TakaI2/Drone_simulate/.tmp/requirements.md

# 要件定義書（plan.txt 精査・ブラッシュアップ版）

作成日: 2026-09-26
元資料: `plan.txt`

---

## 0. plan.txt の精査結果（専門的観点からの指摘）

### 0.1 構成上の指摘

| # | 指摘 | 対応方針 |
|---|---|---|
| A1 | 本文の機能は 1〜4 だが、ゴールは「1〜5 の各段階」「5 の完成機体」となっており段階数が矛盾している。 | 段階5を「統合（Sim-to-Real ループ）」として新設する。設計した実機パラメータでシミュレーションを再実行し、完成機体の3Dを UI に表示する段階とする。 |
| A2 | 段階1（シミュレーション）は機体の質量・慣性・推力係数を必要とするが、それらは段階2・4で決まる。順序どおり進めると段階1のドローンは「仮の機体」になる。 | 全段階で共有する単一の設計データモデル（`DroneDesign`）を定義する。段階1は参照プリセットで実施し、段階5で実設計値を流し込んで再検証する。 |
| A3 | 「偏向しない固定プロペラ」で「単一または複数の推進力」とあるが、固定ピッチ・非偏向ロータでは姿勢4自由度（推力＋ロール・ピッチ・ヨー）の制御に最低4ロータが必要。単発・双発・三発は操舵翼やチルト機構が必須となる。 | 任意 N 基のロータ配置を受け付け、制御配分行列のランク検査で「制御可能か」を判定・警告する。既定はクアッド X 型とし、ヘキサ・オクタも可とする。 |

### 0.2 電気系統の指摘

| # | 指摘 | 対応方針 |
|---|---|---|
| B1 | Raspberry Pi（Linux）はリアルタイム OS ではない。数百 Hz〜kHz の姿勢制御ループを担うフライトコントローラ（FC）には不適。業界の定石は「マイコン FC ＋ Linux コンパニオンコンピュータ」の二層構成。 | 内側ループ（姿勢・角速度制御）はマイコン（ESP32-S3 / STM32 など）が担う。Raspberry Pi は経路計画・画像処理などのコンパニオン（任意）とする。 |
| B2 | ブラシレスモータ用 ESC をディスクリート部品で自作するのは、三相インバータ・ゲートドライバ・センサレス転流が必要で難度が高く、発火リスクもある。 | 機体を2クラスに分ける。**クラスA**（既定）は100g未満のマイクロ機で、ブラシ付きコアレスモータを MOSFET で駆動する。全回路をディスクリート部品と汎用モジュールで構成でき、学習と安全性に優れる。**クラスB** は250mm級のブラシレス機で、ESC は市販品（オープンソースファームウェア AM32 対応品）を採用する。 |
| B3 | 「自律飛行（目標地点・経路）」には自己位置推定が必須。屋内では GPS が使えない。 | クラスAはオプティカルフロー（PMW3901）とToF距離センサ（VL53L1X）で位置推定する（Crazyflie Flow deck と同じ定石）。クラスBは GNSS を使う。シミュレータにもこれらのセンサモデルを入れる。 |
| B4 | MPU-6050 など定番 IMU は製造終了（EOL）品が多く、「替えがきく」方針に反する。 | 現行品（ICM-42688-P、BMI270、LSM6DSO）を採用し、代替候補を必ず併記する。 |
| B5 | 1S LiPo はモータ負荷時に電圧が大きく下がる（サグ）。3.3V レギュレータのドロップアウトでマイコンがブラウンアウトする事故が典型。 | 低ドロップアウト LDO＋バルクコンデンサを使い、電源系を分離する。電圧降下を回路計算とシミュレーション（電池内部抵抗モデル）の両方で扱う。 |

### 0.3 部品・基板の指摘

| # | 指摘 | 対応方針 |
|---|---|---|
| C1 | 販売サイトの自動スクレイピングは多くのサイトで利用規約違反になる。価格・在庫は日々変わる。 | 部品カタログは型番・仕様・寸法・重量を持つローカル DB とする。販売先は各サイトの検索 URL を生成する形にする。将来、公式 API（Digi-Key、Mouser、Nexar/Octopart）連携を追加できる設計にする。 |
| C2 | 「ディスクリート部品の全種類の3Dモデル」は品種が事実上無限で実現不能。 | 規格化された**パッケージ**（EIA チップ 0402〜1206、アキシャル、ラジアル、TO-92、SOT-23、SOIC、QFN、TO-220、ピンヘッダ、JST コネクタ等）ごとのパラメトリック生成器を作る。寸法を入れれば任意の部品を生成できる。高精度モデルが要る場合は KiCad 公式3Dライブラリ（CC-BY-SA 4.0＋設計物例外）を任意で参照する。 |
| C3 | 基板の自動配線は業界ツールでも完全ではない。発注前には必ず人の確認と DRC が必要。 | 自前の2層グリッド配線器で「自動配置→自動配線→GND ベタ→スティッチングビア→サーマルビア→DRC→Gerber 出力」を行う。KiCad で開ける形式でも出力し、人が最終確認・修正できる導線を残す。 |
| C4 | 基板製造サービス（JLCPCB、PCBWay 等）には最小線幅・クリアランス・穴径の制約がある。 | 設計ルールを設定値として外出しする。既定は余裕を持った値（線幅0.2mm、クリアランス0.2mm、ビア0.6/0.3mm）とする。 |

### 0.4 機体設計・法規・その他の指摘

| # | 指摘 | 対応方針 |
|---|---|---|
| D1 | 日本の航空法では 100g 以上の機体は「無人航空機」となり、機体登録とリモート ID が必要。飛行場所の制限も大きい。 | 初号機は 100g 未満（模型航空機扱い）を目標にする。重量予算を常時表示し、100g 超過時に警告する。 |
| D2 | 無線モジュールは日本国内で使うには技適が必要。 | 技適取得済みモジュール（ESP32-S3-WROOM-1、M5Stamp S3 等）のみをカタログで推奨扱いにする。 |
| D3 | シミュレーションと実機の差（Sim-to-Real ギャップ）の主因は推力係数・モータ時定数・慣性モーメントの誤差。 | 推力台での実測値（推力係数 kT、トルク係数 kQ、時定数）を設計データに上書きできるようにし、測定手順をレポートに記載する。 |
| D4 | プロペラ同士、プロペラとフレームの干渉、および CG と推力中心のずれは実機で墜落の主因。 | 機体設計で干渉チェック（プロペラ間隙間）と、CG と推力中心のずれの評価を自動で行う。 |
| D5 | LiPo 電池は過放電・短絡で発火する。 | 電池電圧監視回路（分圧＋ADC）を必須回路とし、低電圧時の自動着陸をシミュレータとファームウェア要件に含める。 |

### 0.5 ライセンス方針（商用利用の観点）

GitHub API で 2026-09-26 に確認した結果は以下のとおり。

| プロジェクト | ライセンス | 本プロジェクトでの扱い |
|---|---|---|
| three.js | MIT | 取り込む（3D 描画） |
| three-bvh-csg / three-mesh-bvh | MIT | 取り込む（ブーリアン演算） |
| PX4-Autopilot | BSD-3-Clause | 制御構造（カスケード PID、ミキサ）の**設計**を参考にする |
| jMAVSim | BSD-3-Clause | 物理モデルの設計を参考にする |
| gym-pybullet-drones / RotorPy / crazyflie-simulation | MIT | 動力学・パラメータ値を参考にする |
| ArduPilot / Betaflight / ESP-Drone / Crazyflie FW / AM32 | GPL-3.0 | **コードは取り込まない**。アルゴリズムと構成の参考のみ。実機ファームウェアをこれらから派生させる場合、そのファームウェアは GPL-3.0 で公開義務が生じる |
| Freerouting | GPL-3.0 | 取り込まない。外部ツールとして任意で使う手順のみ案内する |
| SKiDL | MIT | 参考（本ツールは TypeScript でネットリストを生成） |
| KiCad 3D ライブラリ | CC-BY-SA 4.0（設計物例外あり） | 同梱しない。任意参照とする |
| AirSim / Flightmare | API 判定不能（NOASSERTION） | 参考のみ。コード流用しない |

**結論**: 本ツール本体は MIT/BSD/Apache 系の依存のみで構成し、GPL コードは取り込まない。これにより本ツールの商用利用に制約は生じない。

---

## 1. 目的

飛行体（固定ピッチ・非偏向の多ロータ機）の、シミュレーション・電気設計・基板設計・機体設計を一貫して支援するツールを作る。設計データを単一モデルで共有し、シミュレーション結果と実機設計が整合することを目指す。

## 2. 段階別の機能要件とゴール（合格基準）

各段階はゴール判定をスクリプトで自動化する。結果とスクリーンショットを HTML レポート（`reports/stageN.html`）に出力する。

### 段階1: 飛行空間・シミュレーション

**機能**
- F1-1 Three.js による 3D 空間。重力・空気密度・風（平均風ベクトル＋突風）を設定できる。
- F1-2 地面と障害物（直方体・円柱）、開始点、目標点、経由点をコース定義（JSON）で設定できる。
- F1-3 6自由度剛体動力学。モータ一次遅れ、推力 ∝ ω²、反トルク、空気抵抗、地面効果、電池電圧降下を含む。
- F1-4 センサモデル（IMU ノイズ・バイアス、気圧計、位置センサ）と状態推定。
- F1-5 カスケード制御（位置→速度→姿勢→角速度）と制御配分（任意 N ロータ）。
- F1-6 自律飛行: 障害物を避ける経路計画（3D A*）と経路追従。
- F1-7 手動飛行: キーボード操作。
- F1-8 飛行軌跡の表示、テレメトリ表示、衝突検出。

**ゴール**
| ID | シナリオ | 合格基準 |
|---|---|---|
| G1-1 | 高度1mホバリング10秒（センサノイズあり） | 定常高度誤差 RMS < 0.05 m |
| G1-2 | 正方形コース経由点飛行 | 全経由点を 0.15 m 以内で通過 |
| G1-3 | 障害物コース自律飛行 | 衝突なし、目標到達誤差 < 0.2 m |
| G1-4 | 平均風 3 m/s＋突風 1 m/s 中のホバリング | 水平位置誤差の最大値 < 0.5 m |
| G1-5 | 電池電圧降下 | 低電圧時に自動着陸し、墜落しない |

### 段階2: 推進系サイジングと電気系統設計

**機能**
- F2-1 目標全備重量・推力重量比から、プロペラ・モータ・電池の必要スペックを算出する（運動量理論）。
- F2-2 飛行時間・ホバリング電流・最大電流を推定する。
- F2-3 回路（電源、マイコン、センサ、モータ駆動、電池監視）を自動生成し、各部品の理想スペックを計算する（MOSFET 電流余裕、ゲート抵抗、LDO 電流・ドロップアウト、分圧比など）。
- F2-4 回路図（SVG）、ネットリスト、BOM を出力する。全部品に代替品を1つ以上併記する。

**ゴール**
| ID | 合格基準 |
|---|---|
| G2-1 | 推力重量比 ≥ 2.0、ホバリングスロットル ≤ 60 % |
| G2-2 | 推定ホバリング飛行時間 ≥ 5 分 |
| G2-3 | 電気的検証（電流余裕2倍以上、ADC 入力範囲内、LDO 余裕）がすべて合格 |
| G2-4 | ネットリストに未接続ピン（意図的な NC を除く）がない |

### 段階3: 部品選定・3Dモデル・ブレッドボード・基板設計

**機能**
- F3-1 BOM の各部品を部品カタログ（型番・寸法・重量・仕様・購入先検索 URL）に対応付ける。
- F3-2 パッケージ規格ごとのパラメトリック3Dモデル生成と、アーカイブ（GLB/STL）出力を行う。
- F3-3 ブレッドボード配置図（SVG）を作る。
- F3-4 PCB の自動配置、2層自動配線、GND ベタ、スティッチングビア、発熱部品下のサーマルビア、DRC を行う。
- F3-5 Gerber（RS-274X）とドリル（Excellon）を出力し、基板製造サービスに入稿できる ZIP にまとめる。
- F3-6 実装済み基板の3D表示を行う。

**ゴール**
| ID | 合格基準 |
|---|---|
| G3-1 | BOM 全部品がカタログに対応し、寸法・重量を持つ |
| G3-2 | 使用する全パッケージの3Dモデルが生成される |
| G3-3 | PCB の全ネットが配線済み（未配線 0） |
| G3-4 | DRC（クリアランス・線幅・穴径）違反 0 |
| G3-5 | Gerber 一式とドリルファイルが出力される |

### 段階4: 機体総合設計

**機能**
- F4-1 プロペラ径とクリアランスから腕長を決めるパラメトリックフレームを生成する。
- F4-2 部品配置（基板、電池、モータ、センサ）を行い、質量特性（重心、慣性テンソル）を計算する。
- F4-3 重心と推力中心が一致するよう電池位置を自動調整する。
- F4-4 3Dプリント用 STL を出力する。
- F4-5 電子部品を搭載した機体の3Dを UI で確認できる。

**ゴール**
| ID | 合格基準 |
|---|---|
| G4-1 | 重心と推力中心の水平ずれ < 2 mm |
| G4-2 | プロペラ間・プロペラとフレームの隙間 ≥ 5 mm |
| G4-3 | 出力 STL が閉じた多様体（watertight） |
| G4-4 | 全備重量 < 100 g（クラスA） |

### 段階5: 統合（Sim-to-Real ループ）

**機能**
- F5-1 段階2〜4の設計値（質量、慣性、腕長、推力係数、電池）からシミュレーション用パラメータを自動導出する。
- F5-2 段階1のシナリオを実設計値で再実行し、参照機との比較を行う。
- F5-3 完成機体（フレーム＋基板＋部品＋モータ＋プロペラ＋電池）の3Dを UI 上で表示し、そのまま飛行シミュレーションできる。

**ゴール**
| ID | 合格基準 |
|---|---|
| G5-1 | 実設計値で G1-1〜G1-5 に合格 |
| G5-2 | 完成機体の3Dが UI に表示される（スクリーンショットで確認） |

## 3. 非機能要件

- TypeScript（`any`/`unknown` 禁止、`class` 原則禁止）で実装する。
- コア計算（物理・制御・設計）はブラウザ非依存とし、Node でもテストとバッチ実行ができる。
- 物理は固定刻み 1 kHz、制御は 500 Hz、描画は 60 fps で分離する。
- 設定値はハードコードせず、プリセット・設定ファイルに外出しする。
- 各段階の検証は `npm run stageN` で再現できる。

## 4. スコープ外（今回実施しない）

- 実機ファームウェアの実装（要件と構成案のみ示す）
- 販売サイトのリアルタイム価格取得（API キーが必要なため拡張ポイントのみ用意）
- 構造解析（FEM）と振動解析

---

## 改良版 B（2026-09-27 追加）

元の設計（以下「版 A」：既製フロー＋ToF モジュールをケーブル接続）は変更せずに残し、改良版 B を並行して作る。

### 背景（版 A の課題）
- フロー＋ToF は既製ブレイクアウト頼みで、回路・基板・3D を設計していない（plan.txt の「ディスクリート中心」方針から外れる）。
- メイン基板の J2 とプレート下のモジュールをつなぐケーブルの通り道がフレームにない。
- GNSS（屋外飛行）の接続手段がない。

### 機能要件
- FB-1 フロー（PMW3901 系）＋ToF（VL53L1X）を載せた**センサ子基板**を回路・基板・Gerber・3D まで自動生成する。1.8 V 系電源（フローセンサのコア電圧）を子基板上で作る。
- FB-2 子基板はメイン基板と同じ 8 ピン配列の JST-SH で接続し、フレーム機首の M2 穴 2 個で固定する。部品面を床に向けて取り付ける。
- FB-3 フレームにケーブル通し穴を追加する。
- FB-4 版 B のメイン基板に GNSS 用 JST-SH 6 ピン（3V3・GND・UART TX/RX・I²C）を追加する（モジュール本体は未搭載）。
- FB-5 GNSS の誤差モデル（ゆっくり変動する位置誤差）を追加し、GNSS モジュール装着時の屋外飛行をシミュレーションで検証する。
- FB-6 版 A と版 B の重量・重心・飛行性能を比較する HTML レポートを出力する。UI でも版 B の完成機体を表示・飛行できる。

### ゴール
| ID | 合格基準 |
|---|---|
| GB-1 | 子基板: 全ネット配線・DRC 違反 0・Gerber 構文エラー 0 |
| GB-2 | 版 B メイン基板: 全ネット配線・DRC 違反 0（GNSS コネクタ込み） |
| GB-3 | 版 B 機体: 重心ずれ < 2 mm、STL が閉じた多様体、全備重量 < 100 g |
| GB-4 | 版 B で G1-1〜G1-5 に合格 |
| GB-5 | GNSS 装着の屋外シナリオ（経由点飛行・耐風ホバリング）に合格 |

## 改良版 C：屋外飛行機（2026-09-27 追加）

版 A・版 B は変更せずに残し、屋外（GNSS）で風の中を飛べる機体を「版 C」として同じ段階の進め方（要件→設計→判定スクリプト→HTML レポート）で設計する。

### 背景（屋外で問題になる点と既存資産の流用可否）
| 資産 | 屋外での課題 | 版 C での扱い |
|---|---|---|
| メイン基板（ESP32-S3・IMU・気圧・GNSS 端子） | マイコン・センサ・GNSS 端子はそのまま使える。電源が 1S 専用 LDO（入力 6 V 上限）、モータ駆動がブラシ付き用 MOSFET | **回路ブロックを流用**し、電源を降圧 DC-DC（2〜4S 入力）、モータ駆動を市販 4-in-1 ESC 用端子に差し替えた派生基板を自動生成 |
| センサ子基板（フロー＋ToF） | ToF は日光下で測距距離が大きく低下し、フローは高度数 m 以上で精度が落ちる | 必須にしない。J2 端子は残し、低高度の精密着陸用オプションとして**そのまま装着可能** |
| GNSS＋コンパス（M10 系） | 屋外航法の必須センサ | **そのまま流用**（版 B の 6 ピン端子と同じ配列） |
| 8520 ブラシ付きモータ | 推力重量比 2 前後で強風時の余裕が小さく、ブラシ摩耗・発熱で連続高負荷に弱い | 耐風性能をシミュレーションで比較したうえで、**ブラシレスに変更** |
| フレーム生成器 | モータ固定がブラシ付き用チューブ | 生成器を拡張（ブラシレス用ボルト固定台座・ESC 台・GNSS 台）して**流用** |
| 制御・推定・計画 | 屋外 GNSS 飛行は版 B で検証済み | **流用**。通信断・低電圧時の自動帰還（RTH）を追加 |

### 法規・運用の前提（日本）
- 100 g 未満を維持する（航空法の無人航空機に当たらず、機体登録・リモート ID が不要）。設計目標は組立ばらつきを見込んで 95 g 未満。
- 100 g 未満でも小型無人機等飛行禁止法（重要施設周辺）、空港周辺・高度 150 m 以上の制限、自治体条例・公園ルールは適用される。
- 2.4 GHz 無線は技適取得済みモジュール（ESP32-S3-WROOM-1）のみ。GNSS は受信のみ。
- 100 g 以上の構成（例：250 級 5 インチ）は比較対象としてだけ示す。

### 機能要件
- FC-1 屋外用の部品候補（ブラシレス 11〜14 級モータ、2.5〜3.5 インチプロペラ、2S/3S 電池）と屋外用設計基準（推力重量比 ≥ 3、ホバリングスロットル ≤ 45 %、飛行時間 ≥ 7 分、全備重量 < 95 g）で推進系を探索する。版 A の候補表・探索結果は変えない。
- FC-2 版 B のメイン基板回路から、電源（降圧 DC-DC）とモータ出力（ESC 用 JST-SH 8 ピン：電源・電流・4 信号・テレメトリ）を差し替えた版 C 基板を生成し、電気計算（降圧器・分圧器・ESC 電流余裕等）を行う。
- FC-3 版 C 基板を自動配置・配線し、DRC・Gerber・KiCad・3D を出力する。
- FC-4 フレーム生成器にブラシレスモータ用ボルト固定台座、ESC スタック、GNSS 台座（機首上面）を追加し、重心・隙間・強度・STL を検証する。
- FC-5 通信断・低電圧時に自動帰還（上昇→ホームへ移動→着陸）するフェイルセーフを追加する。
- FC-6 屋外シナリオ（耐風ホバリング、広域の経由点飛行、強風、自動帰還）と、版 B（GNSS 装着）との耐風限界比較をシミュレーションで行う。
- FC-7 版 C の HTML レポート（流用判断、探索、回路、基板、機体、飛行、懸念点）と UI 表示（完成機体・基板・屋外飛行）。

### ゴール
| ID | 合格基準 |
|---|---|
| GC-1 | 屋外基準を満たす推進系が存在し、全備重量 < 95 g、TWR ≥ 3 |
| GC-2 | 版 C 回路の電気計算が全項目合格、1 ピンだけのネットなし |
| GC-3 | 版 C 基板：全ネット配線・DRC 違反 0・Gerber 構文エラー 0 |
| GC-4 | 版 C 機体：重心ずれ < 2 mm、STL 閉多様体、プロペラ隙間、腕強度安全率 ≥ 3、全備重量 < 100 g |
| GC-5 | 屋外シナリオ（平均風 5 m/s ホバリング・40 m 経由点飛行・平均風 8 m/s 強風）各 5 シードで合格 |
| GC-6 | 通信断で自動帰還し、ホームから 3 m 以内に着陸（5 シード） |
| GC-7 | 平均風 8 m/s のホバリングでモータ指令（99 パーセンタイル）が 60 % 以下、かつ版 B（GNSS 装着、同じ屋外制御設定）より推力余裕が大きい |

- GC-7 は当初「耐風限界（位置保持できる最大風速）が版 B を上回る」としていたが、試算で耐風限界は抗力/質量比と傾き制限でほぼ決まり、版 B と版 C で差が出ないことが分かったため（抗力モデル ×1・×2 とも同等）、設計で差が出る「推力余裕」に改めた。耐風限界の比較はレポートに参考として載せる。

## 都市シミュレーション：横浜・みなとみらい（2026-09-28 追加）

実在の街並み（建物）を読み込み、屋外機（版 C）の飛行・経路計画をシミュレーションで検証できるようにする。

### データとライセンス
| データ | 用途 | ライセンス・表記 |
|---|---|---|
| OpenStreetMap（Overpass API） | 建物外形・高さ／階数タグ、公園 | ODbL。「© OpenStreetMap contributors」を表示。加工 DB を配布する場合は同条件 |
| PLATEAU 横浜市（2024 年度、CityGML v4、建築物 LOD1） | 建物外形と高さ（主データ） | PLATEAU サイトポリシー（CC BY 4.0 相当）。「3D 都市モデル（Project PLATEAU）横浜市（2024 年度）（国土交通省）を加工して作成」 |

- PLATEAU の CityGML は市全体で 2.7 GB の ZIP。ZIP の中央ディレクトリを HTTP Range で読み、対象の 3 次メッシュ（53391540・53391550）の建築物ファイルだけを取得する。
- 取得した生データは `.cache/`（Git 管理外）、変換後の建物データは `out/city/` に置く。

### 機能要件
- FY-1 緯度経度を対象地域の原点を基準とする ENU（m）に変換し、建物を「外形ポリゴン × 高さ」の角柱障害物にする。
- FY-2 角柱障害物を当たり判定・経路計画（ボクセル A*）に対応させる。数百 m 規模でも実用的な時間で計画できること（空間インデックス、列単位のボクセル化）。
- FY-3 GNSS の都市劣化：地点ごとの天空の見通し率（建物に遮られない空の割合）から位置誤差を拡大し、見通しが極端に悪い所では測位が途切れる。
- FY-4 高さで変わる風（べき乗則）。
- FY-5 法規チェック：飛行高度（地表から 150 m 未満）、公園（横浜市の公園は原則ドローン禁止のため要確認）との交差、人口集中地区の注意喚起。
- FY-6 UI で都市モデルと飛行を 3D 表示する。HTML レポートを出力する。

### ゴール
| ID | 合格基準 |
|---|---|
| GY-1 | OSM と PLATEAU から対象範囲の建物を取得・変換できる。高さの一致をランドマークタワー等で確認 |
| GY-2 | 高度 40 m で建物群を縫う経路を計画でき、建物からの距離が安全余裕以上 |
| GY-3 | 開けた空を仮定した GNSS で、版 C が経路を 5 シードすべて衝突なく飛行・着陸 |
| GY-4 | 天空見通しによる GNSS 劣化＋高さの風を入れても 5 シードすべて衝突なし（必要なら安全余裕を設計し直す） |
| GY-5 | 経路の法規チェック結果（高度・公園・DID）をレポートに出す |
| GY-6 | UI で都市と飛行の 3D 表示ができる（スクリーンショット） |

## 予算（部品価格）（2026-09-28 追加）

- FP-1 部品ごとの参考価格表を作る。価格は Web 検索で個別に確認した値（販売サイトの自動収集はしない）と、確認できなかった品目の推定値を区別し、参照元・確認日・価格幅（下限〜上限）を付ける。
- FP-2 版 A・B・C について「1 機分の部品代」と「初回に必要な費用（基板の最小ロット、実装費、送料、税、予備）」を計算する。道具（充電器、書込み治具など）は別枠。
- FP-3 為替・送料・税率・購入数は設定（`src/budget/prices.ts`）で変えられる。
- FP-4 HTML レポート（`reports/budget.html`）と CSV を出力する。

| ID | 合格基準 |
|---|---|
| GP-1 | 版 A・B・C の BOM の全品目に価格が付いている（価格なし 0） |
| GP-2 | 各版の 1 機分・初回費用・道具の合計と内訳、価格幅を出力 |
