TakaI2/Drone_simulate/.tmp/tasks.md

# タスクリスト

| # | タスク | 段階 | 状態 |
|---|---|---|---|
| 0 | プロジェクト雛形（Vite、TS、Vitest、ESLint、git） | 0 | 完了 |
| 1 | core: 数学ライブラリ、型、乱数、プリセット | 1 | 完了 |
| 2 | sim: モータ、電池、風、動力学、衝突、センサ、推定器 | 1 | 完了 |
| 3 | control: PID、カスケード制御、配分、飛行モード | 1 | 完了 |
| 4 | planning: ボクセル、A*、短縮、追従 | 1 | 完了 |
| 5 | sim: シミュレータ本体、シナリオ G1-1〜G1-5 | 1 | 完了 |
| 6 | ui: シミュレーション画面（環境、軌跡、テレメトリ、手動操作） | 1 | 完了 |
| 7 | scripts: 段階1判定、撮影、HTML レポート | 1 | 完了 |
| 8 | sizing: 推進系サイジングと組合せ探索 | 2 | 完了 |
| 9 | electrical: カタログ、回路生成、計算、回路図 SVG、BOM | 2 | 完了 |
| 10 | ui＋レポート: 段階2 | 2 | 完了 |
| 11 | parts3d: パッケージ生成器、アーカイブ | 3 | 完了 |
| 12 | pcb: フットプリント、配置、配線、GND、ビア、DRC | 3 | 完了 |
| 13 | pcb: Gerber・ドリル・ZIP、ブレッドボード図 | 3 | 完了 |
| 14 | ui＋レポート: 段階3 | 3 | 完了 |
| 15 | airframe: フレーム生成、質量特性、バランス、STL | 4 | 完了 |
| 16 | ui＋レポート: 段階4 | 4 | 完了 |
| 17 | integration: パラメータ導出、再シミュレーション、比較 | 5 | 完了 |
| 18 | ui＋レポート: 段階5、総合目次 | 5 | 完了 |
| 19 | GitHub へ push | - | 完了 |

## 実装結果（2026-09-26）

- 全タスク完了。`npm run all` で段階1〜5 のゴール判定（全 21 項目合格）・成果物・HTML レポートを再生成できる。
- 単体テスト 25 件（`npm test`）、型検査・lint（`npm run typecheck` / `npm run lint`）すべて合格。

## 改良版 B

| # | タスク | 状態 |
|---|---|---|
| B1 | 回路: GNSS コネクタ（オプション）、子基板回路、部品カタログ | 完了 |
| B2 | 基板パイプライン: 長方形基板・取付穴位置指定、子基板の配置配線 | 完了 |
| B3 | フレーム: ケーブル穴、子基板の質量・3D | 完了 |
| B4 | センサ: GNSS 誤差モデル、屋外シナリオ | 完了 |
| B5 | スクリプト・比較レポート・UI の版切替 | 完了 |
| B6 | テスト・lint・コミット | 完了 |

- 改良版 B 完了（2026-09-27）：`npm run variantB` で GB-1〜GB-5 全合格。推定器の傾き観測性の欠陥を修正（版 A も再検証済み・全合格）。

## 改良版 C（屋外機）

| # | タスク | 状態 |
|---|---|---|
| C1 | 屋外用推進系候補・基準・質量モデル、探索の差し替え | 完了 |
| C2 | 回路: 降圧 DC-DC・ESC 端子オプション、部品カタログ、電気計算 | 完了 |
| C3 | 基板: 版 C 基板の配置配線・Gerber | 完了 |
| C4 | フレーム: ボルト固定台座・ESC スタック・GNSS 台座、3D | 完了 |
| C5 | シミュレーション: RTH、屋外ゲイン、屋外シナリオ、耐風限界 | 完了 |
| C6 | スクリプト・レポート・UI（版 C） | 完了 |
| C7 | テスト・lint・コミット | 完了 |

- 改良版 C 完了（2026-09-27）：`npm run variantC` で GC-1〜GC-7 全合格。構成は 1204 5000KV・3 インチ 3 枚羽・2S 450 mAh・市販 4-in-1 ESC、全備 93.6 g、基板 38×38 mm。
- 試算で分かったこと：位置を保てる最大風速は抗力/質量比と傾き制限でほぼ決まり、版 B＋GNSS と版 C で差がない。版 C の利点は推力余裕（平均風 8 m/s でモータ指令 34 % 対 53 %）と耐久性。GC-7 をこれに合わせて改めた。

## 都市シミュレーション（横浜）

| # | タスク | 状態 |
|---|---|---|
| Y1 | geo：ENU・OSM・CityGML 解析、データ取得とキャッシュ | 完了 |
| Y2 | 角柱障害物：当たり判定・索引・ボクセル化・計画パラメータ | 完了 |
| Y3 | 天空見通しと GNSS 劣化、高さの風 | 完了 |
| Y4 | シナリオ・法規チェック・スクリプト・レポート | 完了 |
| Y5 | UI（都市タブ） | 完了 |
| Y6 | テスト・lint・コミット | 完了 |

- 都市シミュレーション完了（2026-09-28）：`npm run city` で GY-1〜GY-6 全合格。安全余裕 3 m では都市の GNSS 劣化で 1/5 シードが建物に接触、8 m で全シード接触なし。
- 途中で推定器の不具合（長距離飛行後に傾き推定が約 9° ずれ、推定速度に偽の 1.4 m/s）を発見。GNSS 補助の傾き補正からジャイロバイアスも推定するよう修正し、段階1〜5・版 B・版 C を再検証（全合格）。
- ユーザーマニュアル `docs/manual.md` を新規作成（`npm run manual` でスクリーンショット更新）。

## 予算（後続）

| # | タスク | 状態 |
|---|---|---|
| P1 | 部品価格表（参照元・調査日付き）と版 A/B/C の予算計算・レポート | 完了 |
| P2 | 価格表（Web 確認分／推定分）・予算計算・レポート・マニュアル追記 | 完了 |

- 予算完了（2026-09-28）：`npm run budget`。1 機分 A 約 1.2 万円・B 約 1.4 万円・C 約 2.4 万円、初回 A 約 3.7 万・B 約 4.4 万・C 約 5.2 万円。価格調査で、小型 12 A の AM32 単体 ESC がほぼ市販されていないこと、市販 M10 GNSS が 7.7 g（想定 5 g より重い）ことが判明。
