TakaI2/Drone_simulate/docs/img/ui-6-city-follow.png

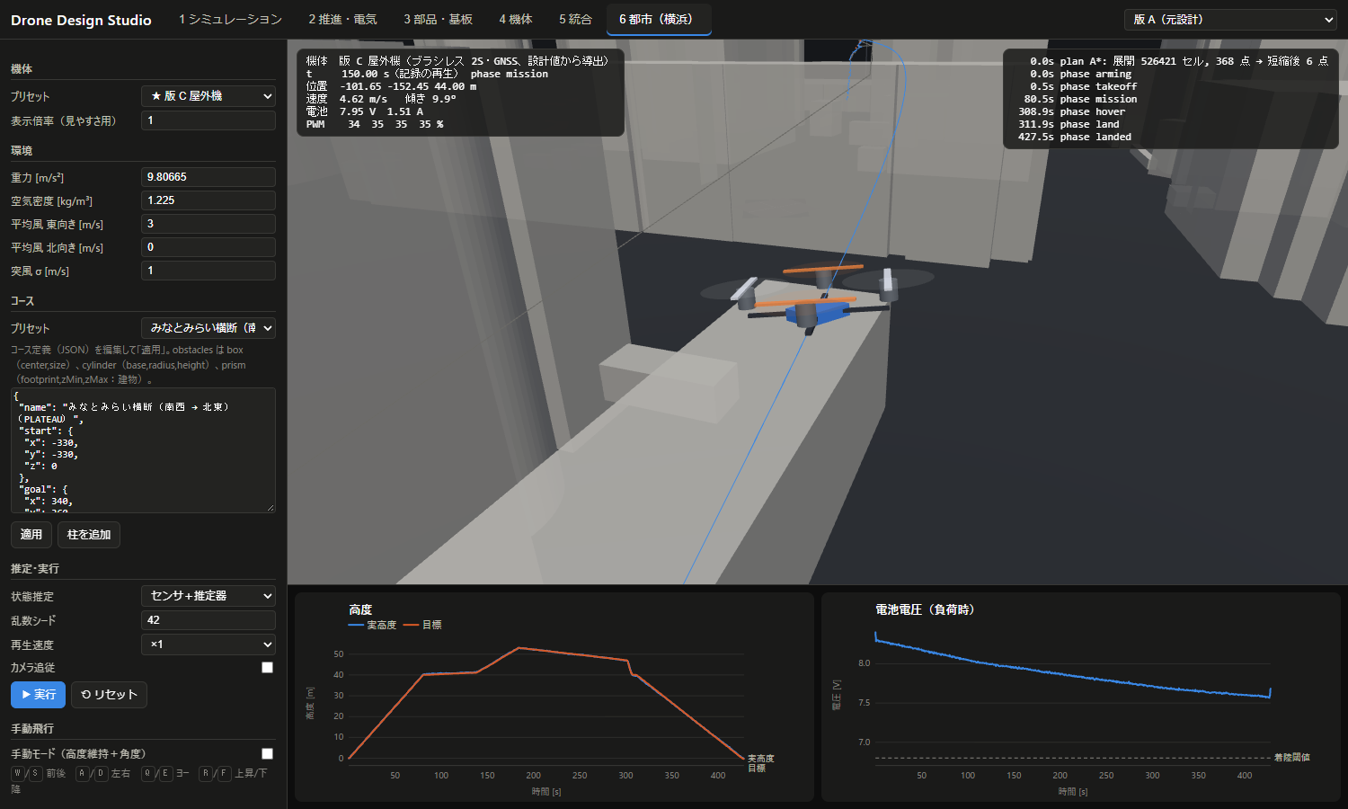
docs/img/ui-6-city-follow.png
