TakaI2/Drone_simulate/docs/video/airframe-a-orbit.png

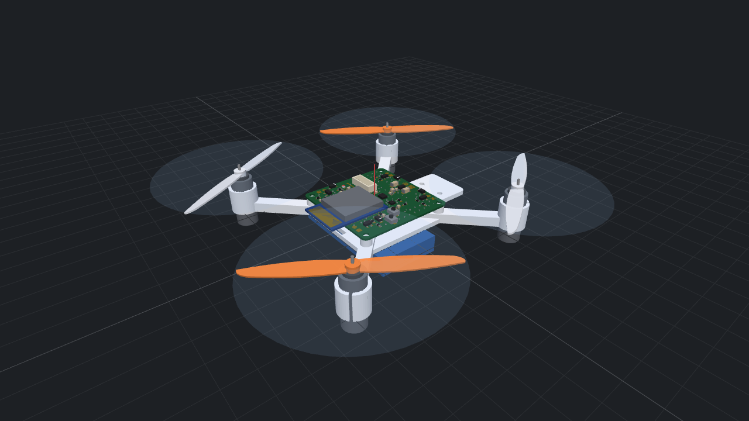
docs/video/airframe-a-orbit.png
