TakaI2/Drone_simulate/docs/video/airframe-c-orbit.png

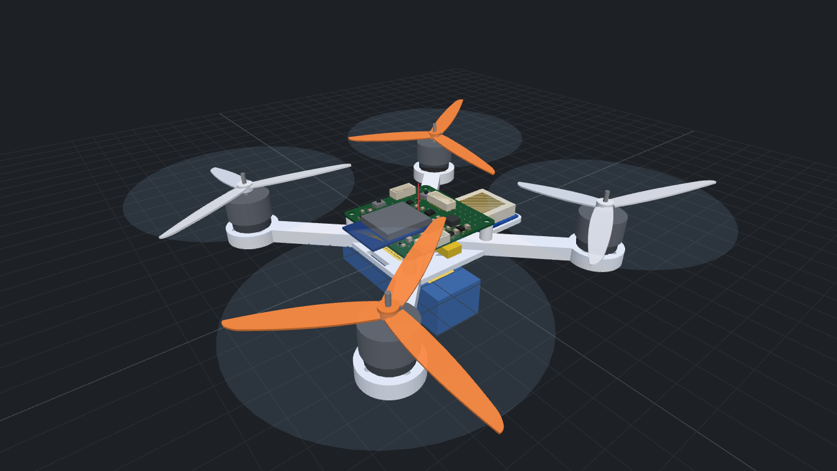
docs/video/airframe-c-orbit.png
