TakaI2/Drone_simulate/docs/video/indoor-chase.png

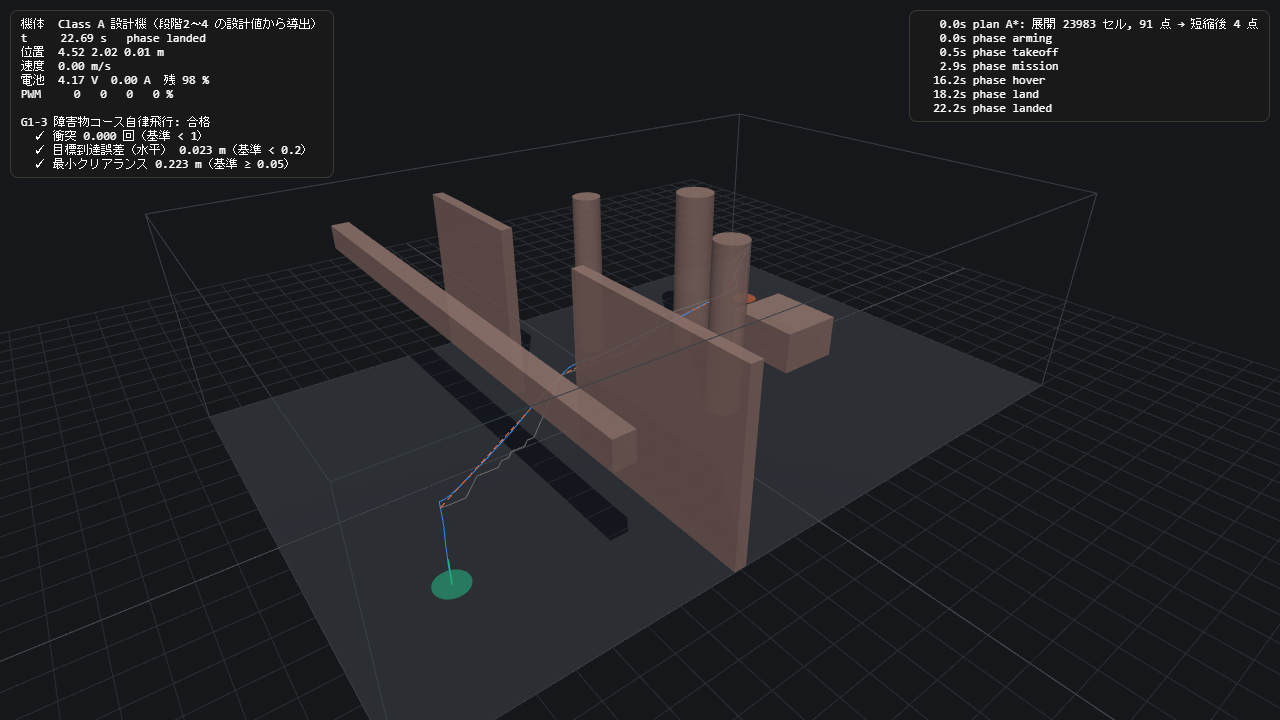
docs/video/indoor-chase.png
