TakaI2/Drone_simulate/docs/video/outdoor-square-chase.png

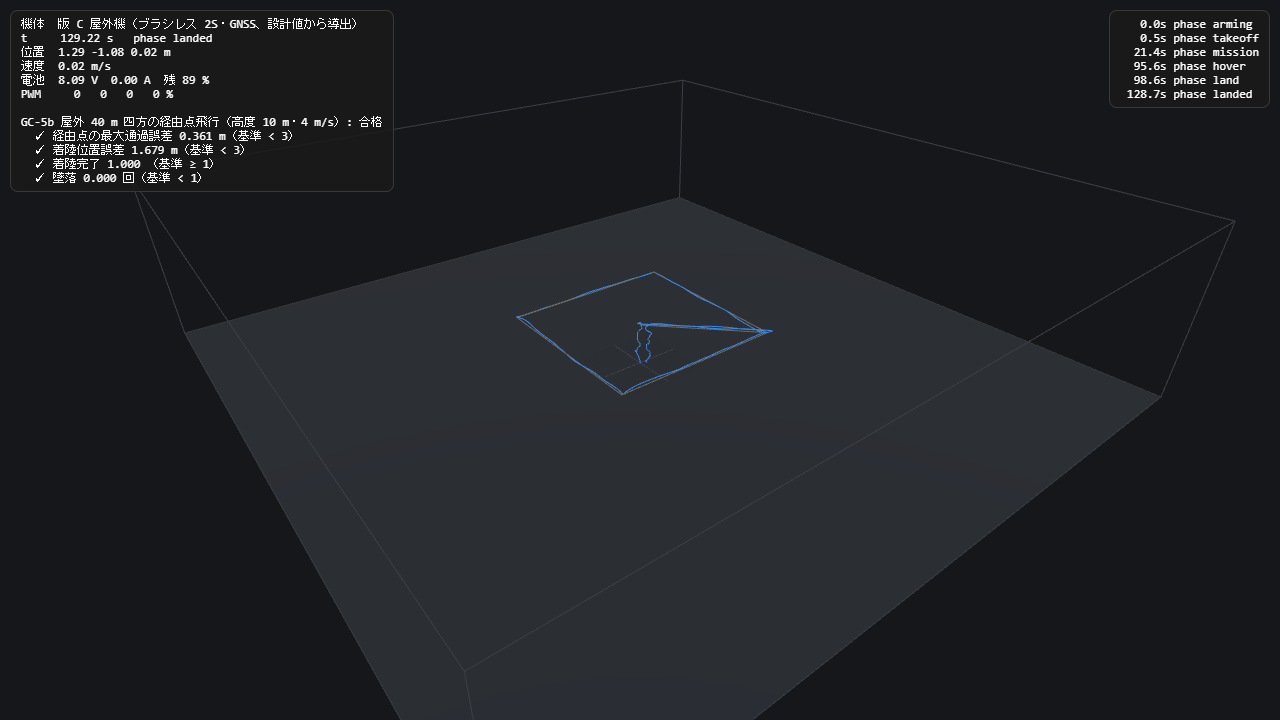
docs/video/outdoor-square-chase.png
