TakaI2/Drone_simulate/docs/video/pcb-a-orbit.png

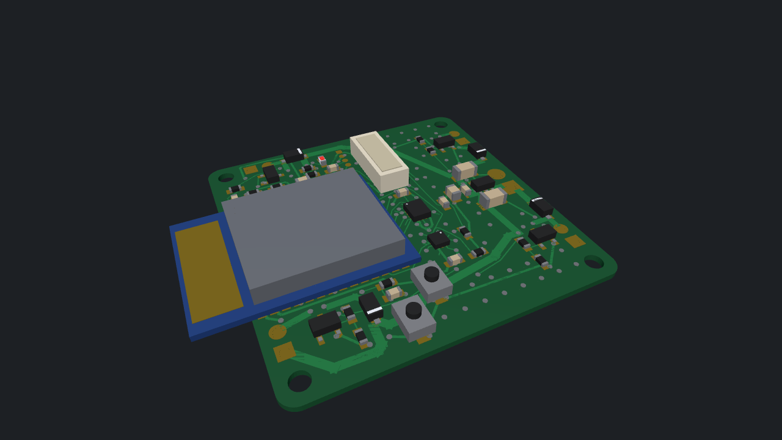
docs/video/pcb-a-orbit.png
