TakaI2/Drone_simulate/docs/video/pcb-c-orbit.png

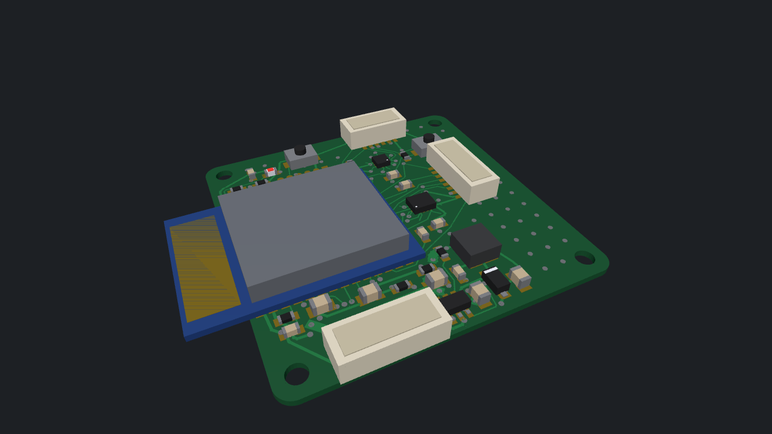
docs/video/pcb-c-orbit.png
