TakaI2/Drone_simulate/docs/video/pcb-flow-orbit.png

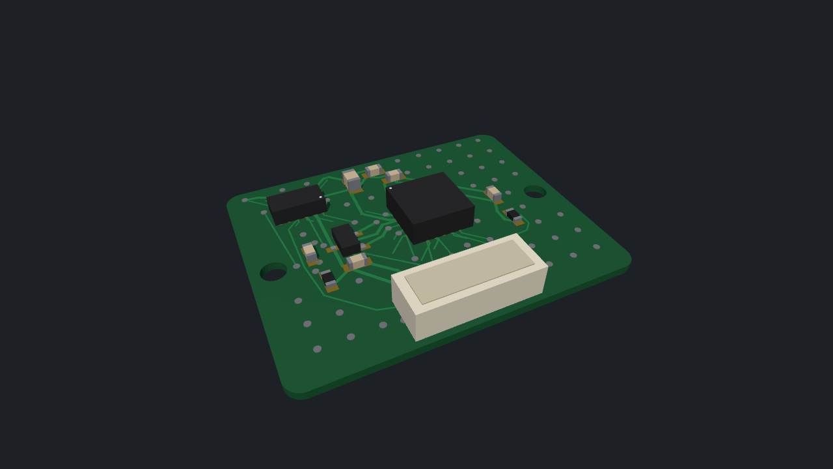
docs/video/pcb-flow-orbit.png
