TakaI2/Drone_simulate/reports/img/city-follow.png

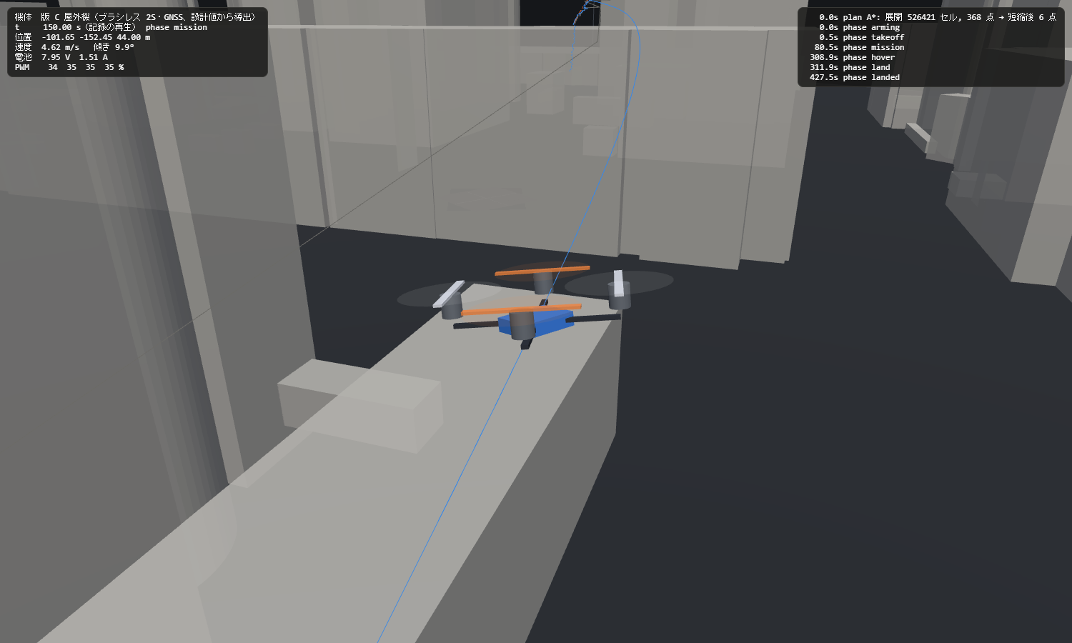
reports/img/city-follow.png
