TakaI2/Drone_simulate/reports/img/city-iso.png

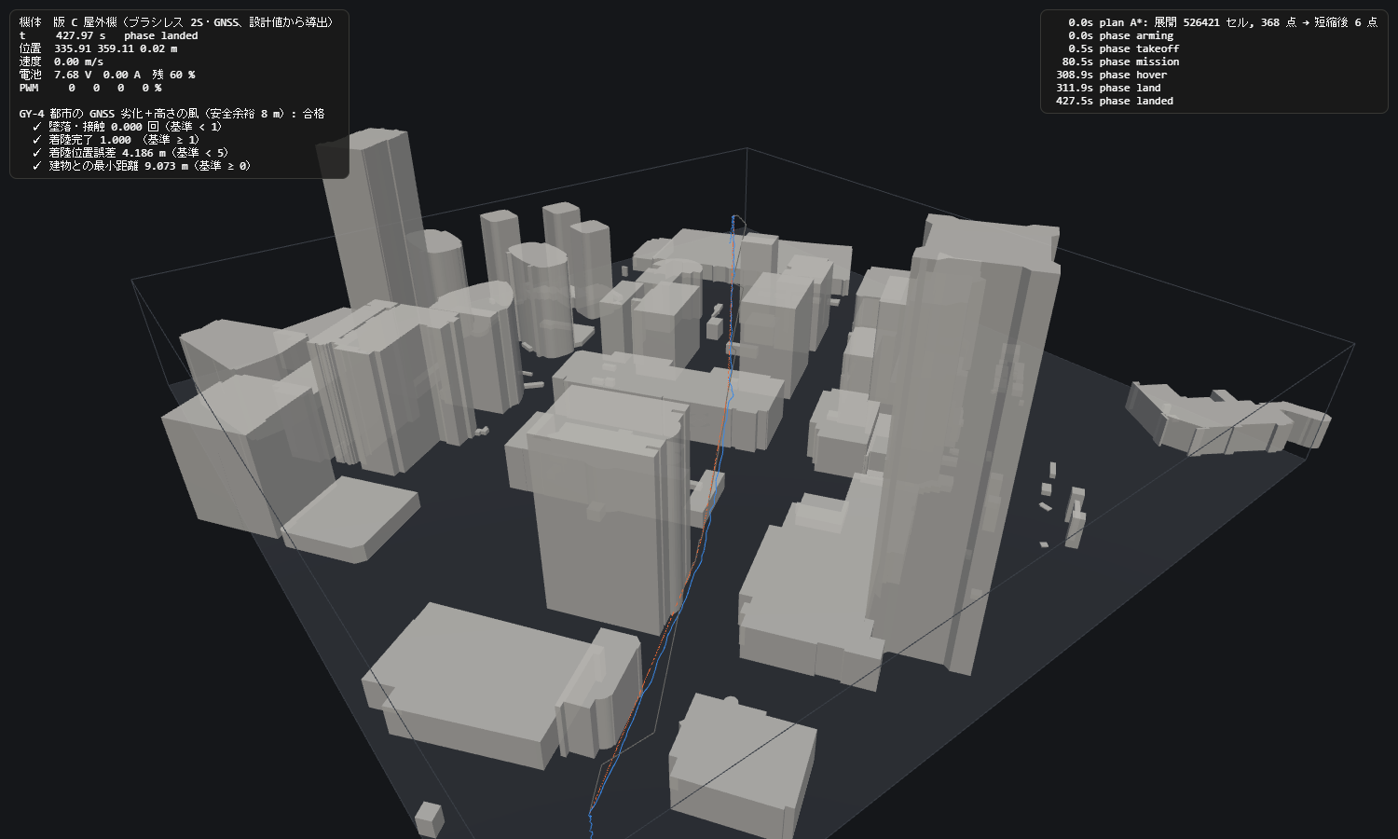
reports/img/city-iso.png
