TakaI2/Drone_simulate/reports/img/city-top.png

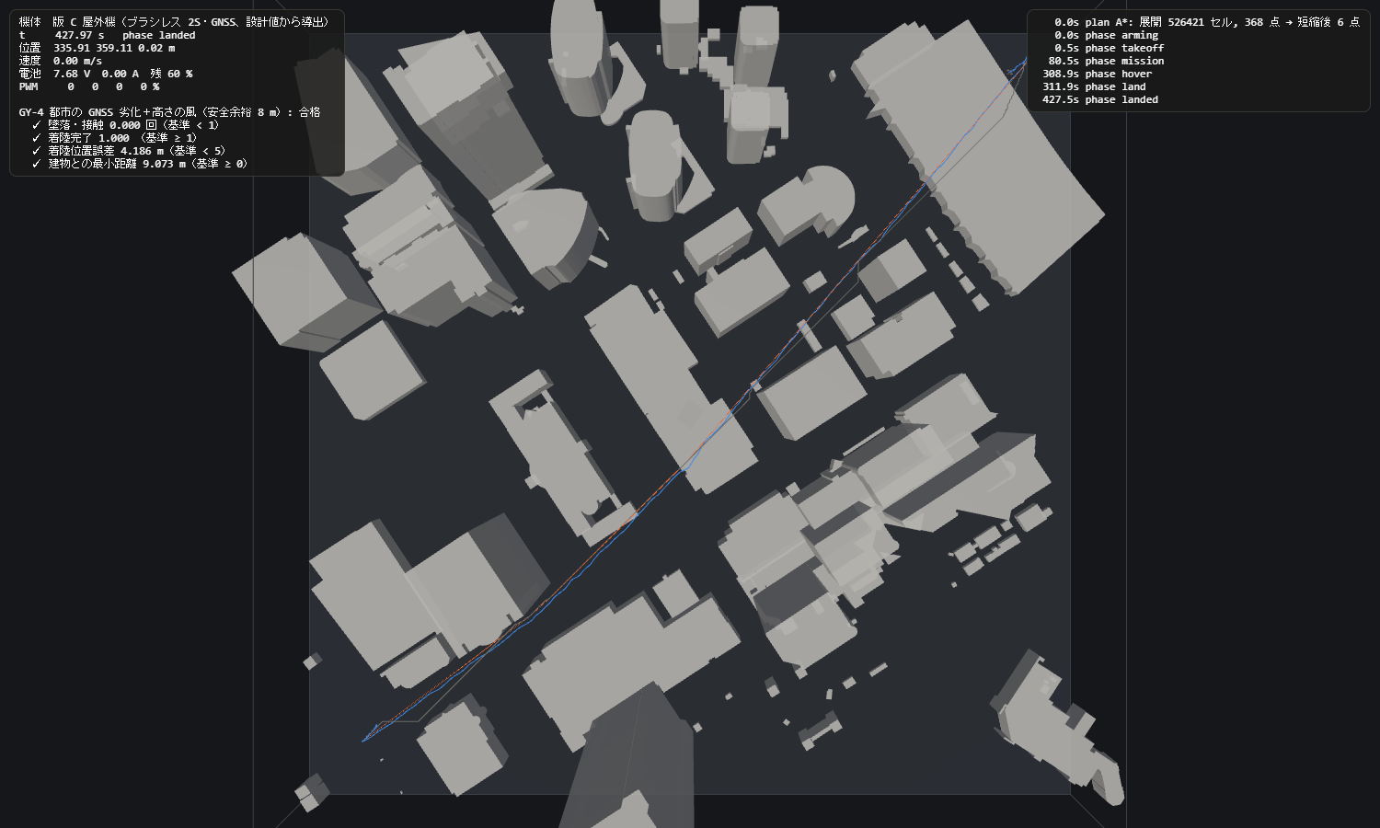
reports/img/city-top.png
