TakaI2/Drone_simulate/reports/img/stage1-G1-1.png

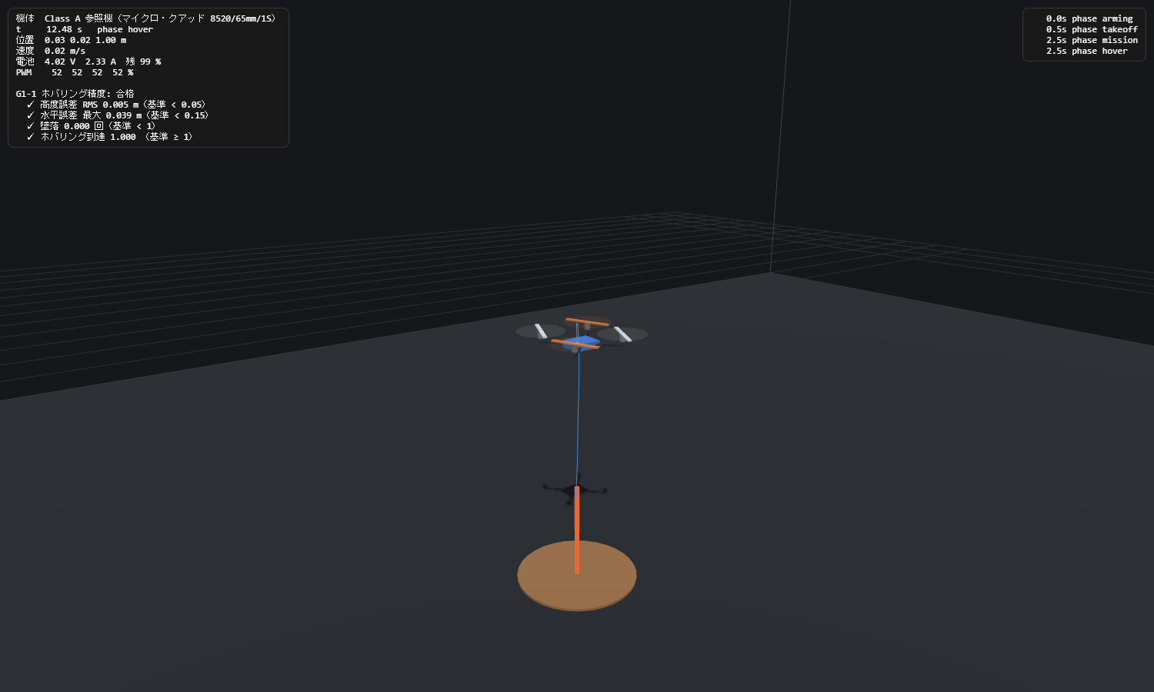
reports/img/stage1-G1-1.png
