TakaI2/Drone_simulate/reports/img/stage1-G1-2.png

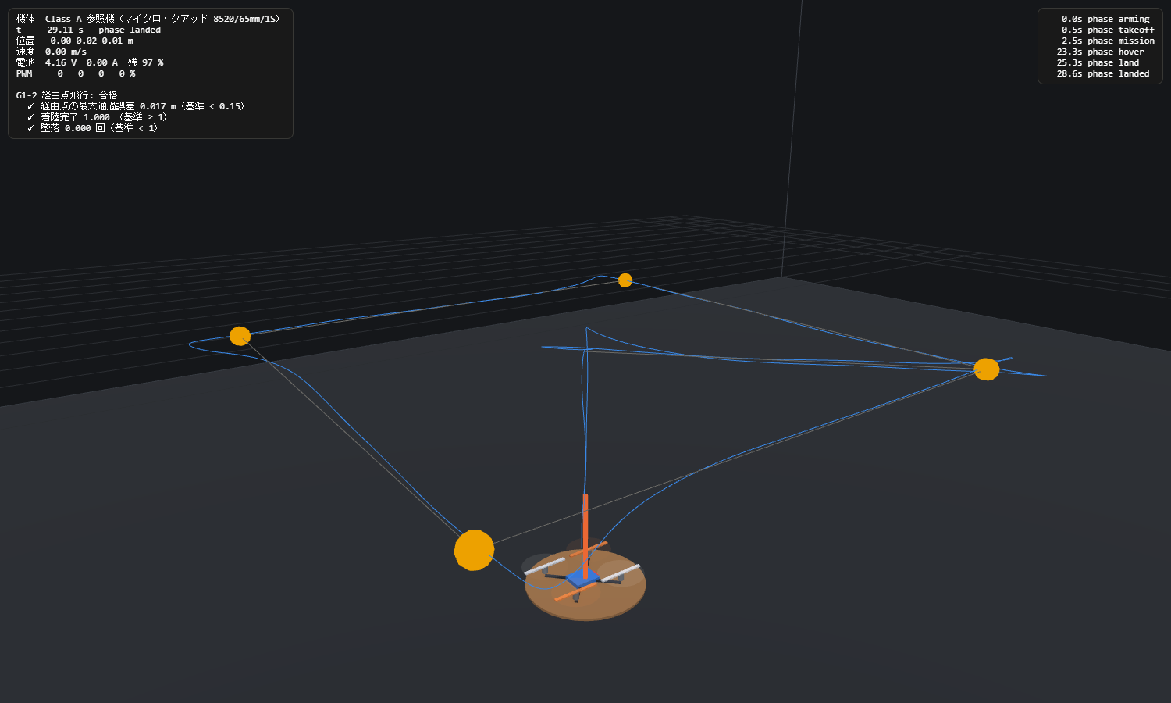
reports/img/stage1-G1-2.png
