TakaI2/Drone_simulate/reports/img/stage1-G1-3-top.png

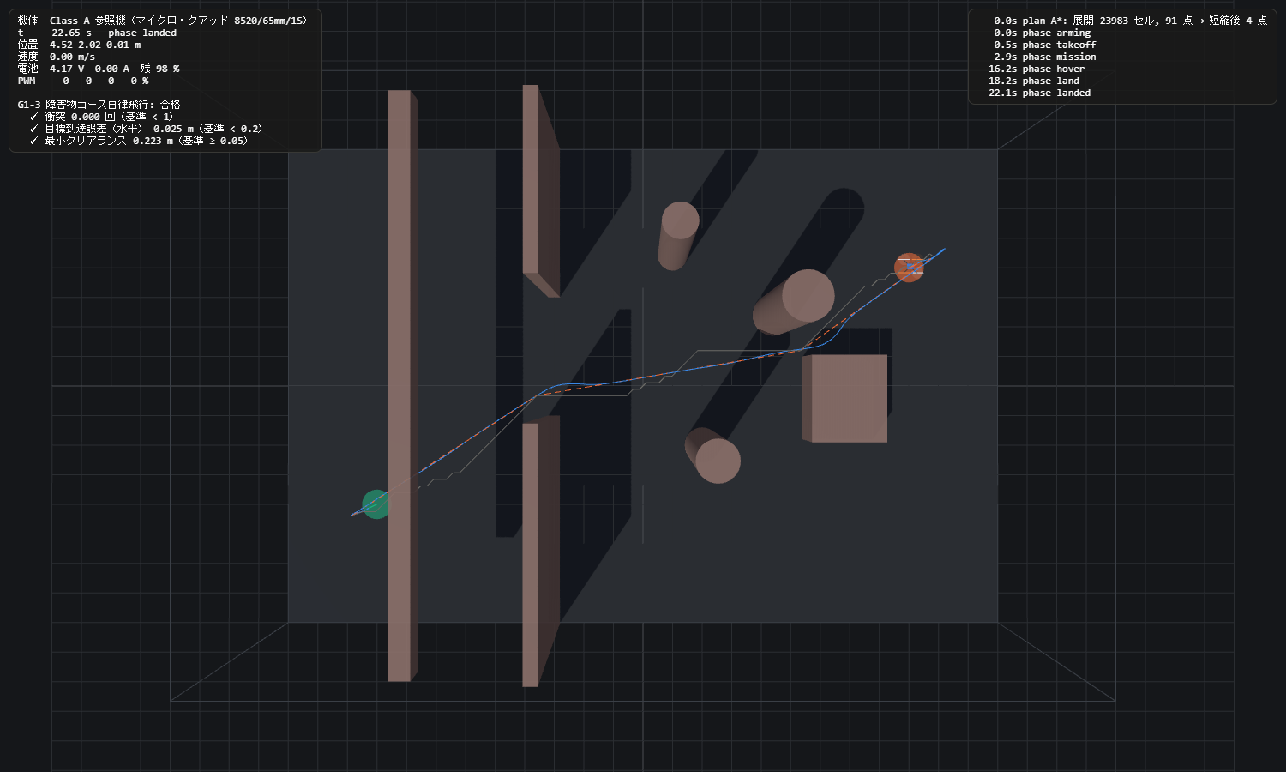
reports/img/stage1-G1-3-top.png
