TakaI2/Drone_simulate/reports/img/stage1-G1-5.png

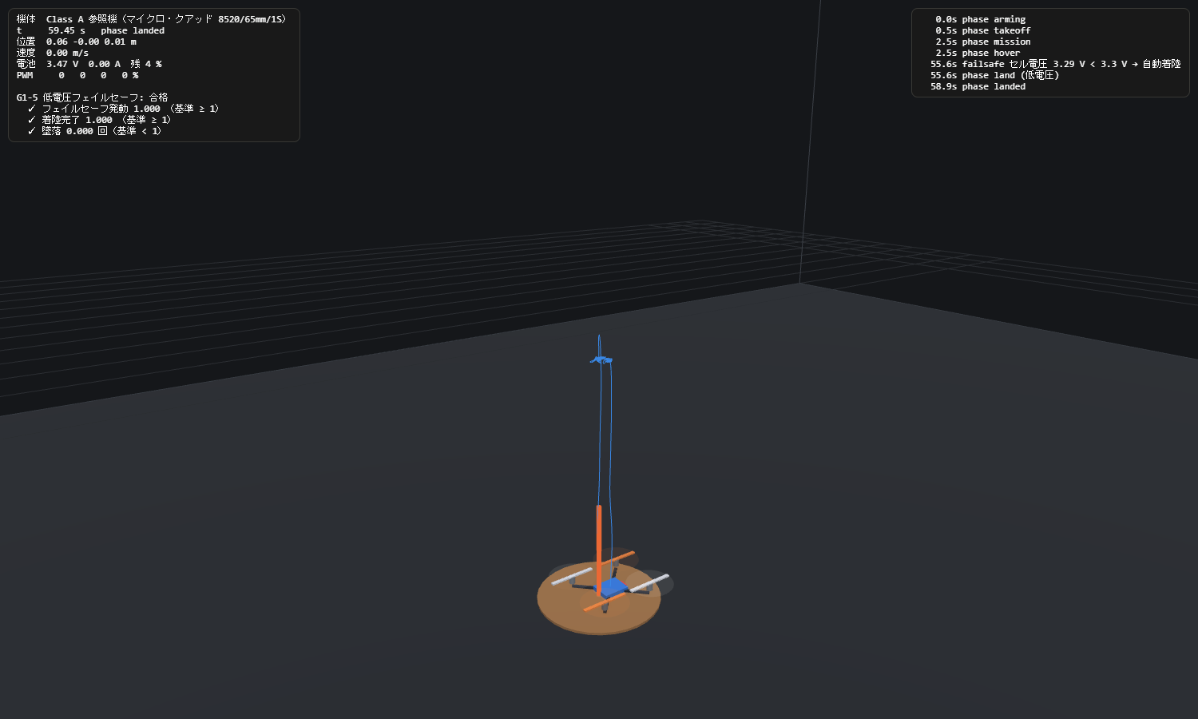
reports/img/stage1-G1-5.png
