TakaI2/Drone_simulate/reports/img/stage2-ui.png

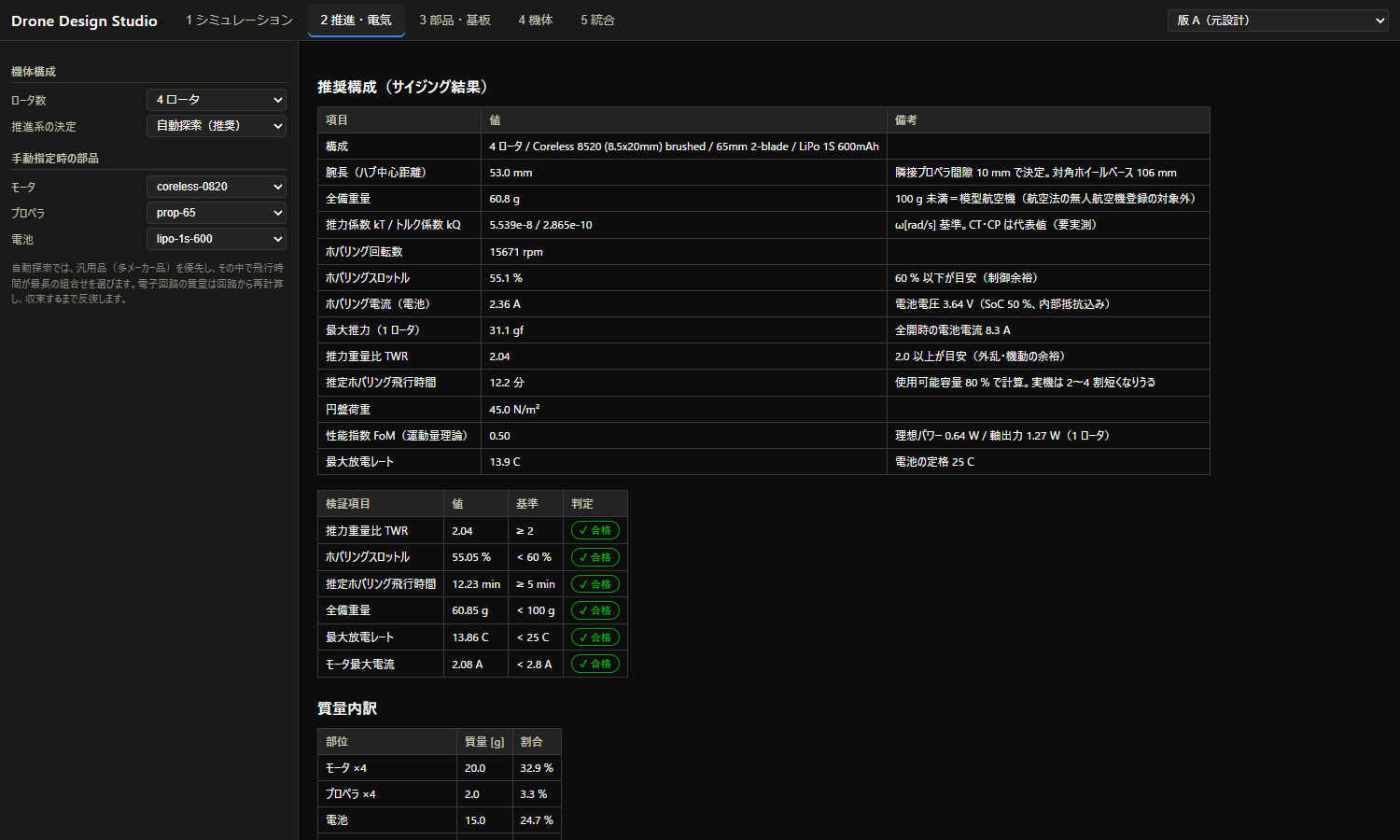
reports/img/stage2-ui.png
