TakaI2/Drone_simulate/reports/img/stage3-lib.png

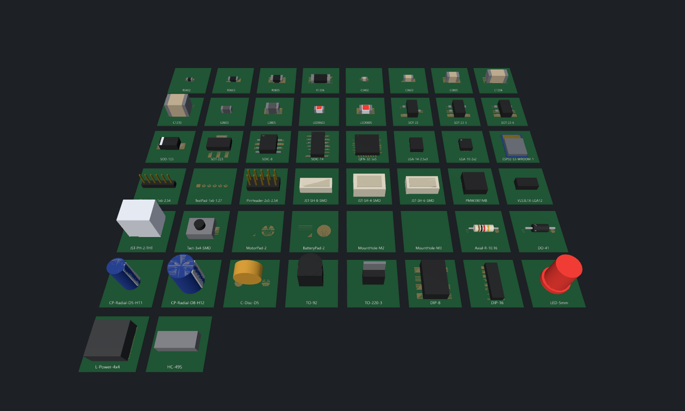
reports/img/stage3-lib.png
