TakaI2/Drone_simulate/reports/img/stage3-pcb-3d.png

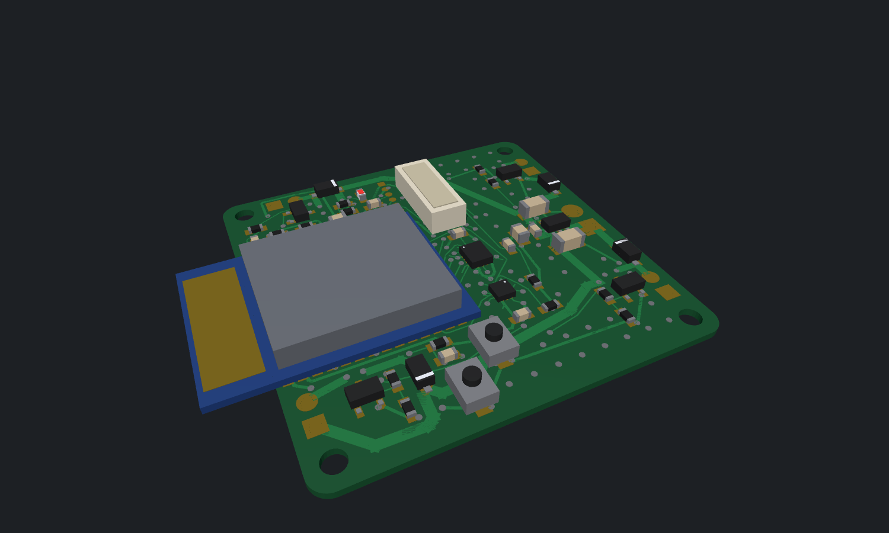
reports/img/stage3-pcb-3d.png
