TakaI2/Drone_simulate/reports/img/stage3-ui.png

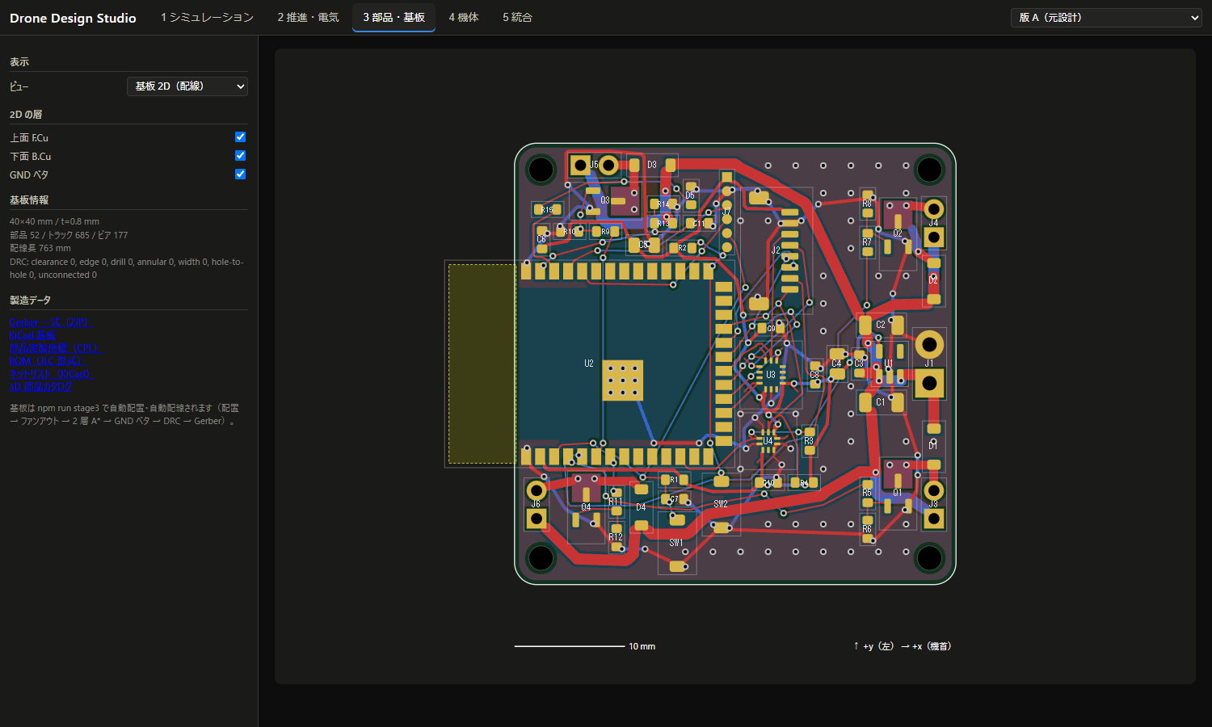
reports/img/stage3-ui.png
