TakaI2/Drone_simulate/reports/img/stage4-bottom.png

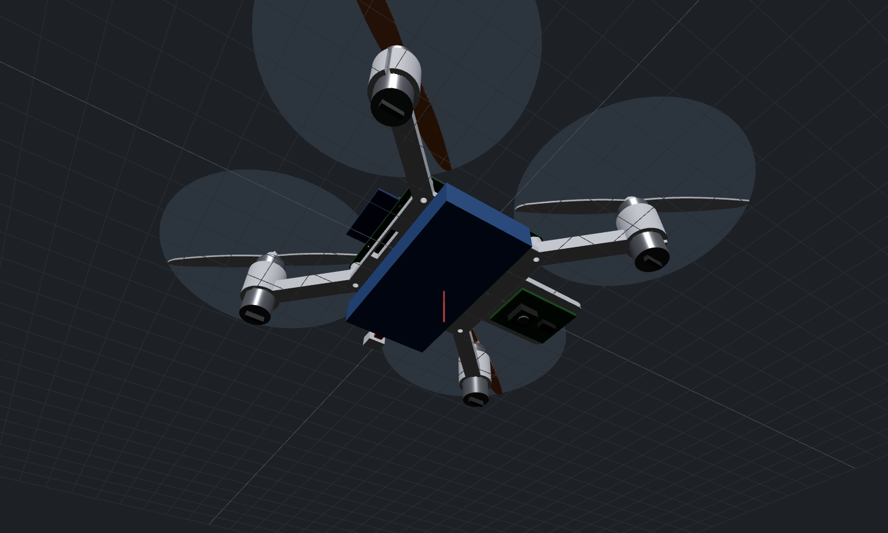
reports/img/stage4-bottom.png
