TakaI2/Drone_simulate/reports/img/stage4-frame.png

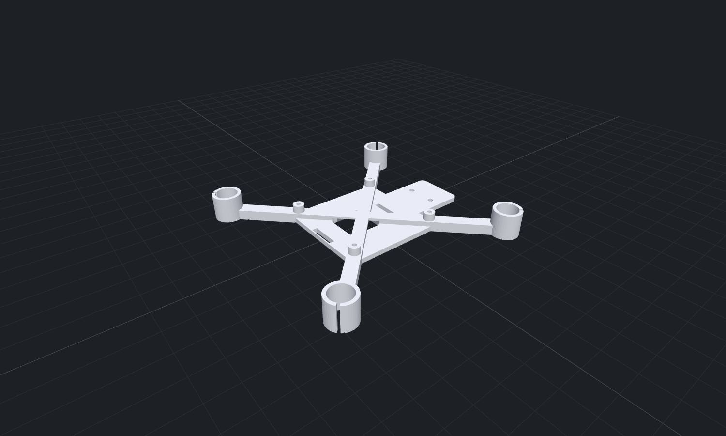
reports/img/stage4-frame.png
