TakaI2/Drone_simulate/reports/img/stage4-side.png

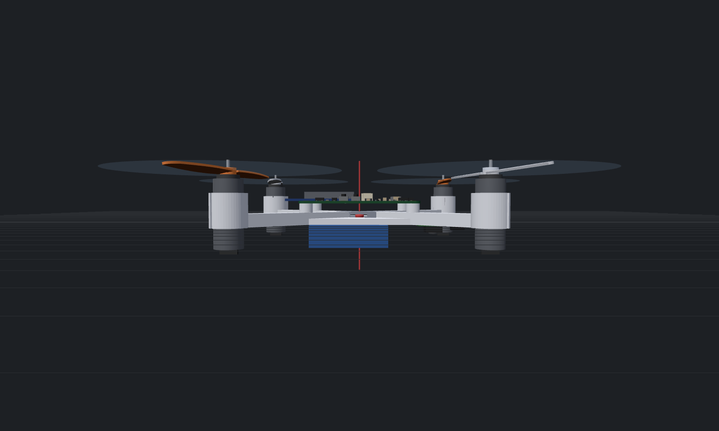
reports/img/stage4-side.png
