TakaI2/Drone_simulate/reports/img/stage4-top.png

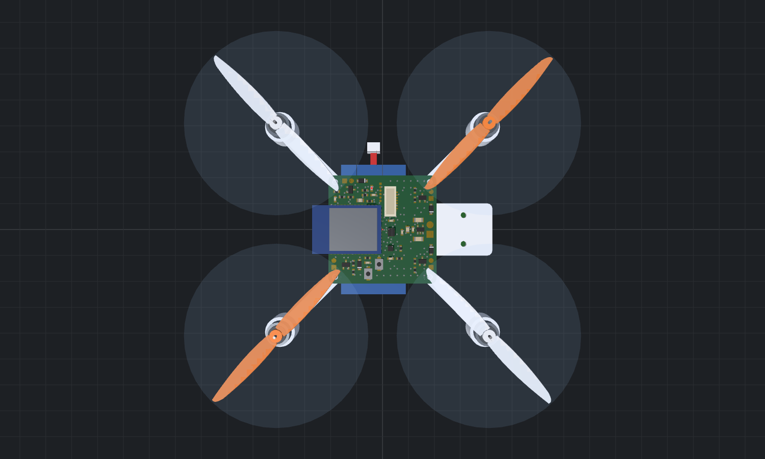
reports/img/stage4-top.png
