TakaI2/Drone_simulate/reports/img/stage5-fly-1.png

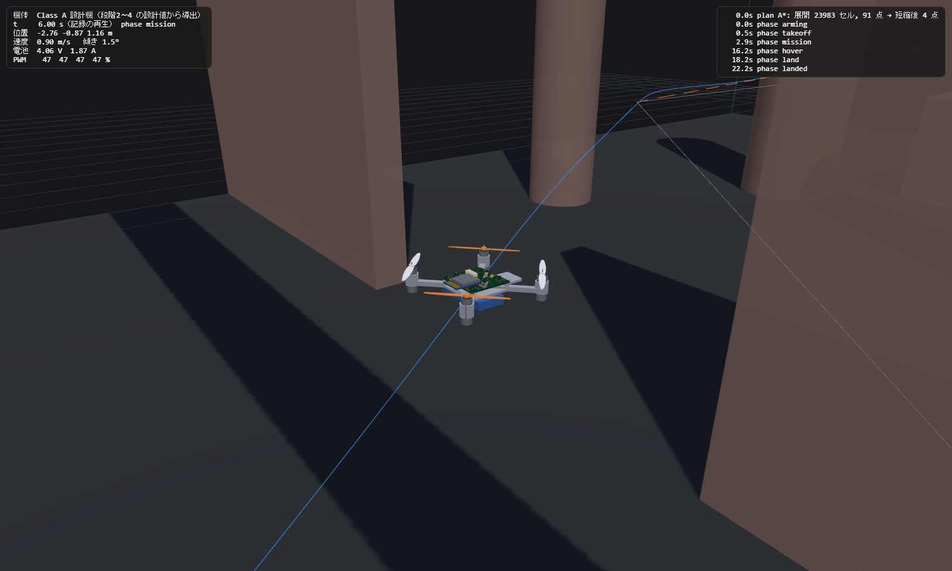
reports/img/stage5-fly-1.png
