TakaI2/Drone_simulate/reports/img/stage5-fly-2.png

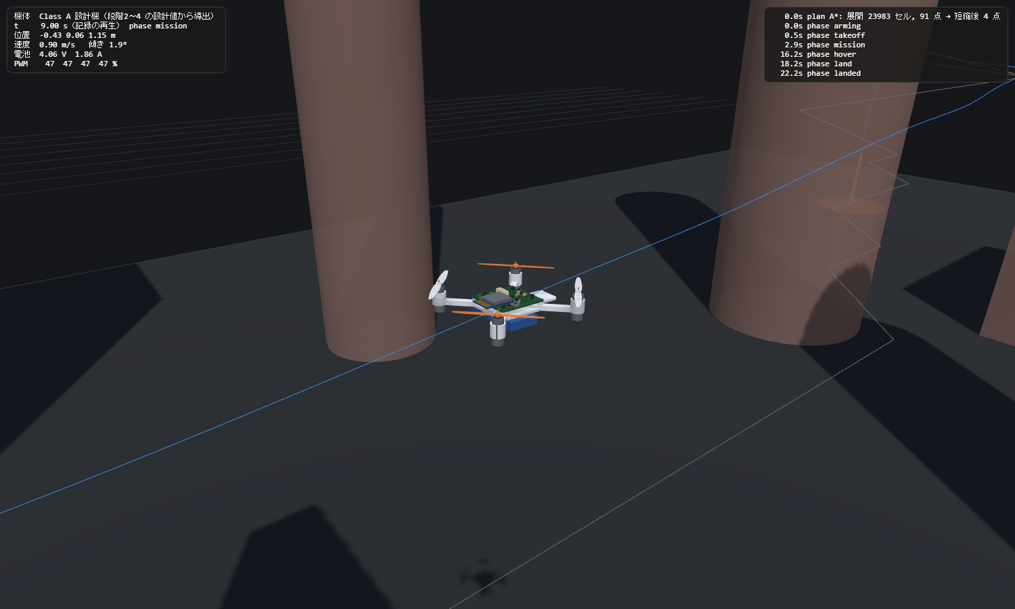
reports/img/stage5-fly-2.png
