TakaI2/Drone_simulate/reports/img/stage5-fly-3.png

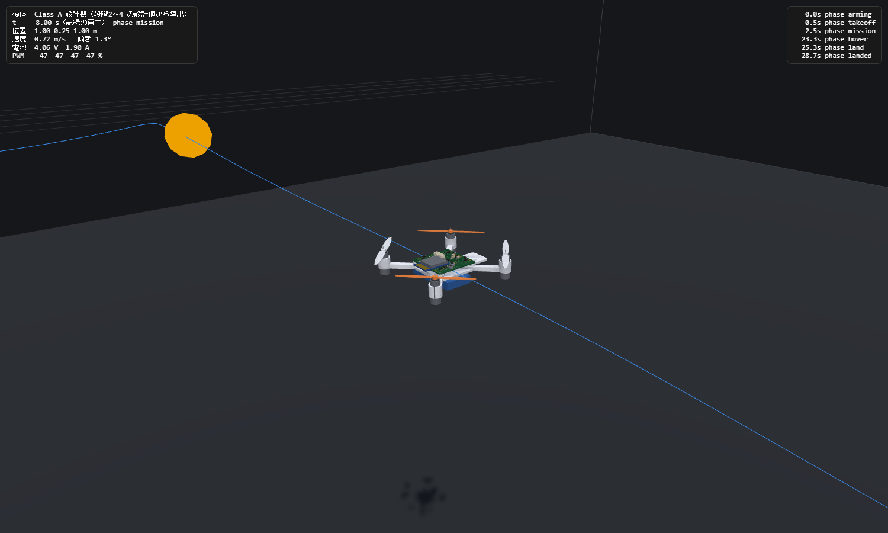
reports/img/stage5-fly-3.png
