TakaI2/Drone_simulate/reports/img/stage5-ui.png

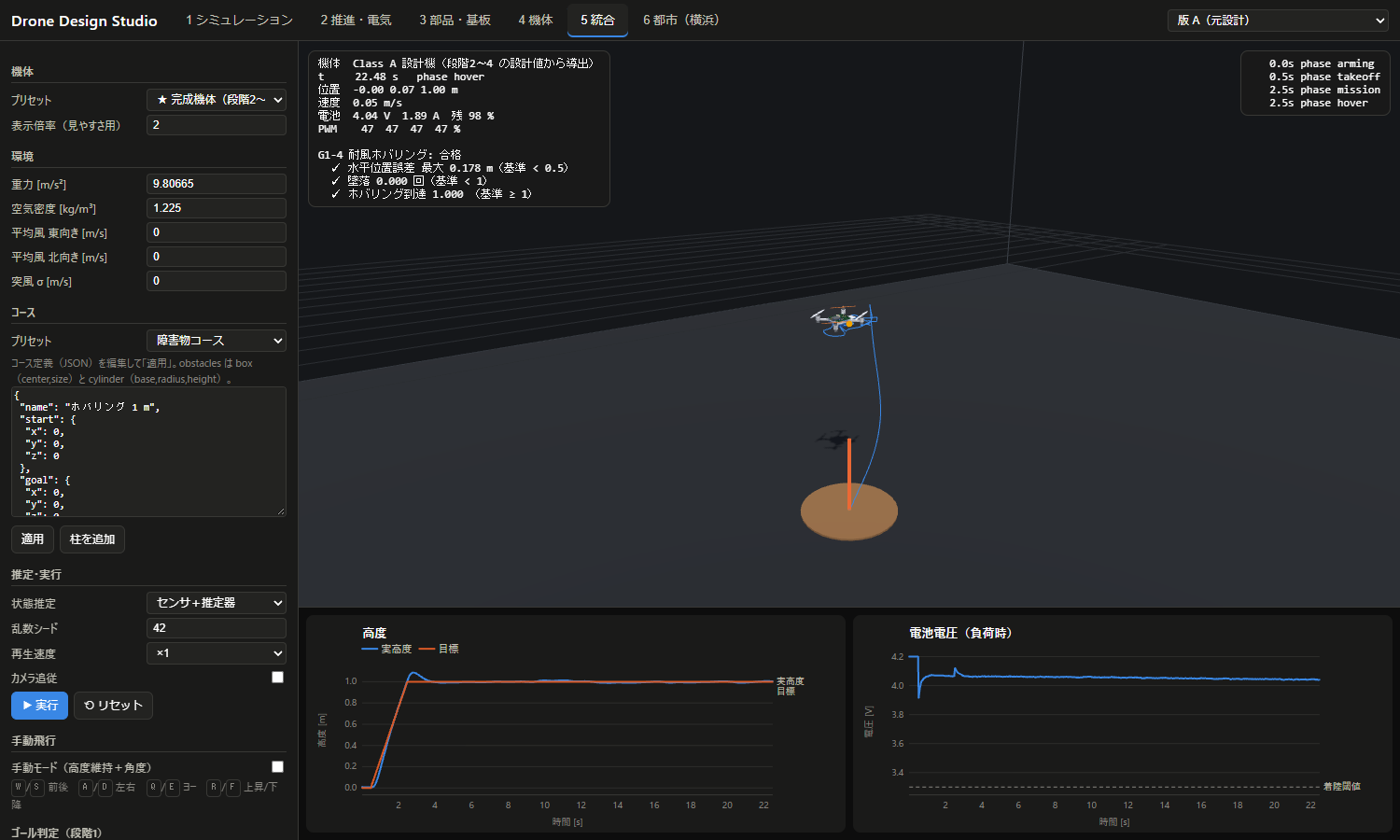
reports/img/stage5-ui.png
