TakaI2/Drone_simulate/reports/img/variantB-gnss-top.png

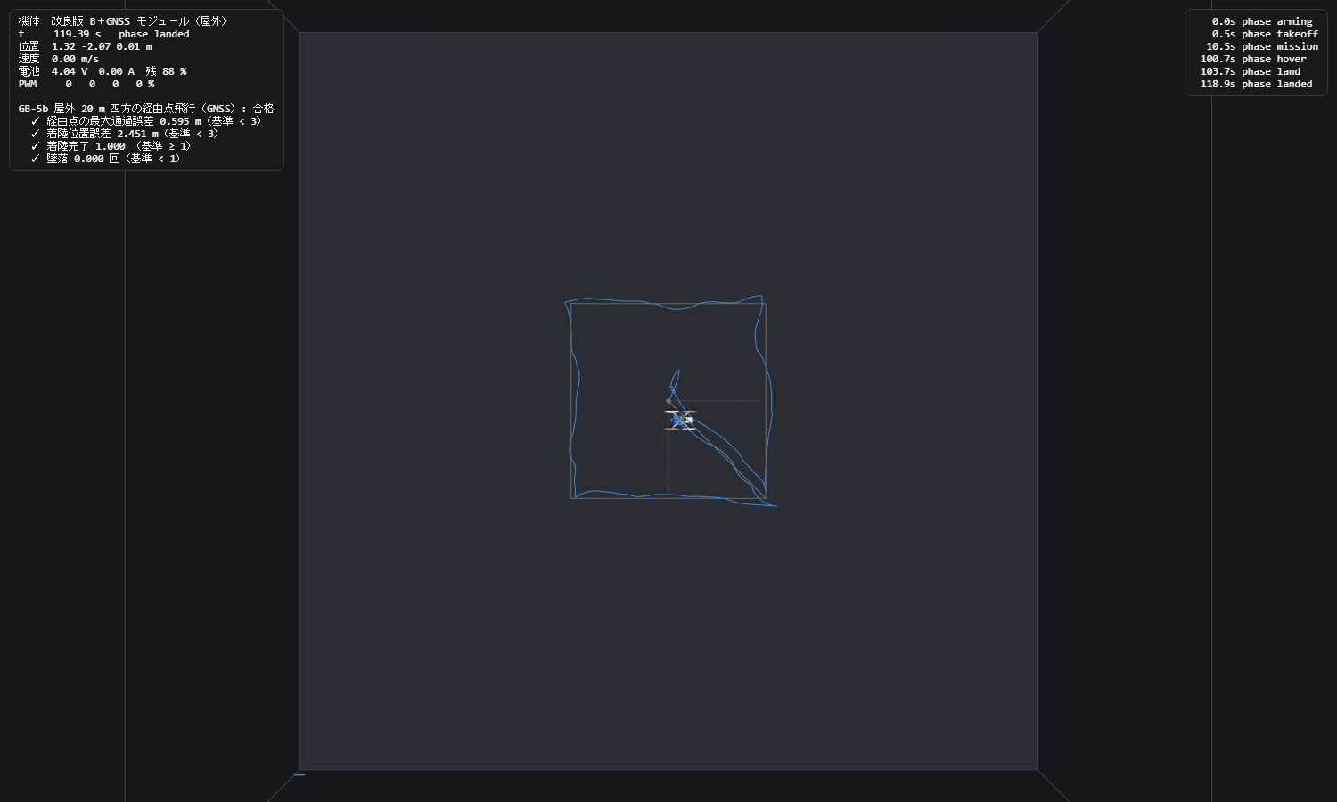
reports/img/variantB-gnss-top.png
