TakaI2/Drone_simulate/reports/img/variantC-fly.png

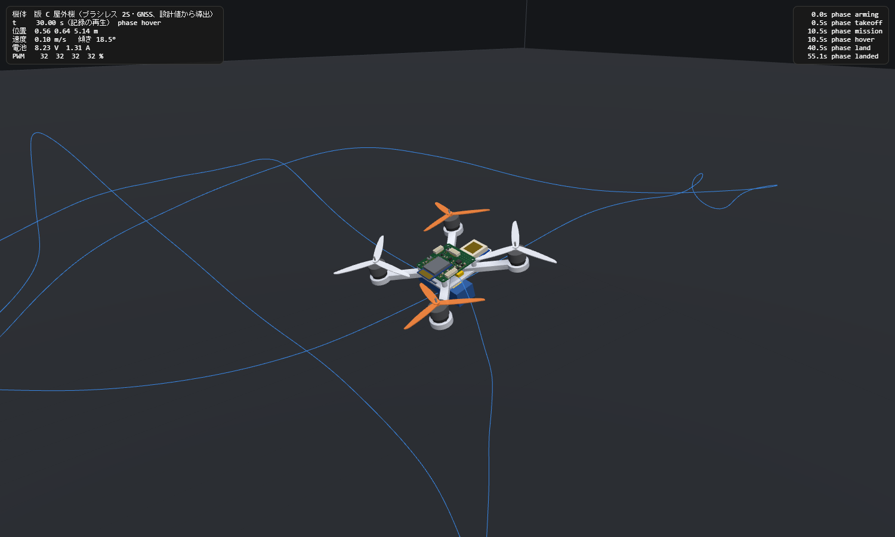
reports/img/variantC-fly.png
