TakaI2/Drone_simulate/reports/img/variantC-frame.png

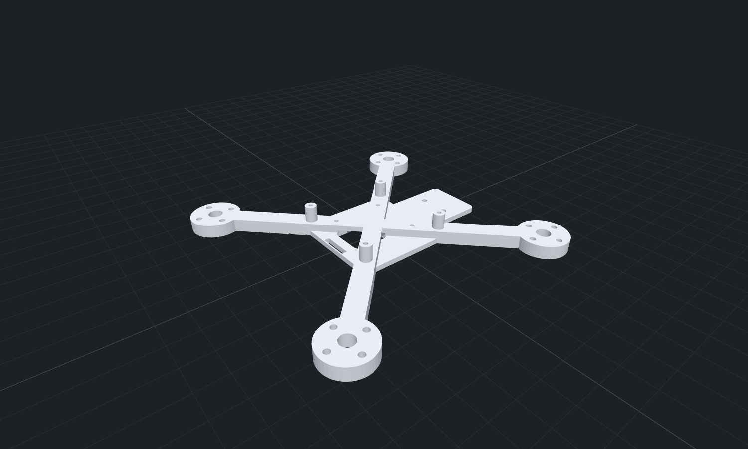
reports/img/variantC-frame.png
