TakaI2/Drone_simulate/reports/img/variantC-iso.png

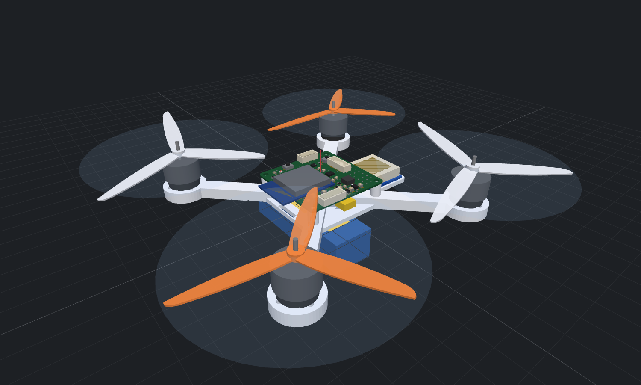
reports/img/variantC-iso.png
