TakaI2/Drone_simulate/reports/img/variantC-rth-top.png

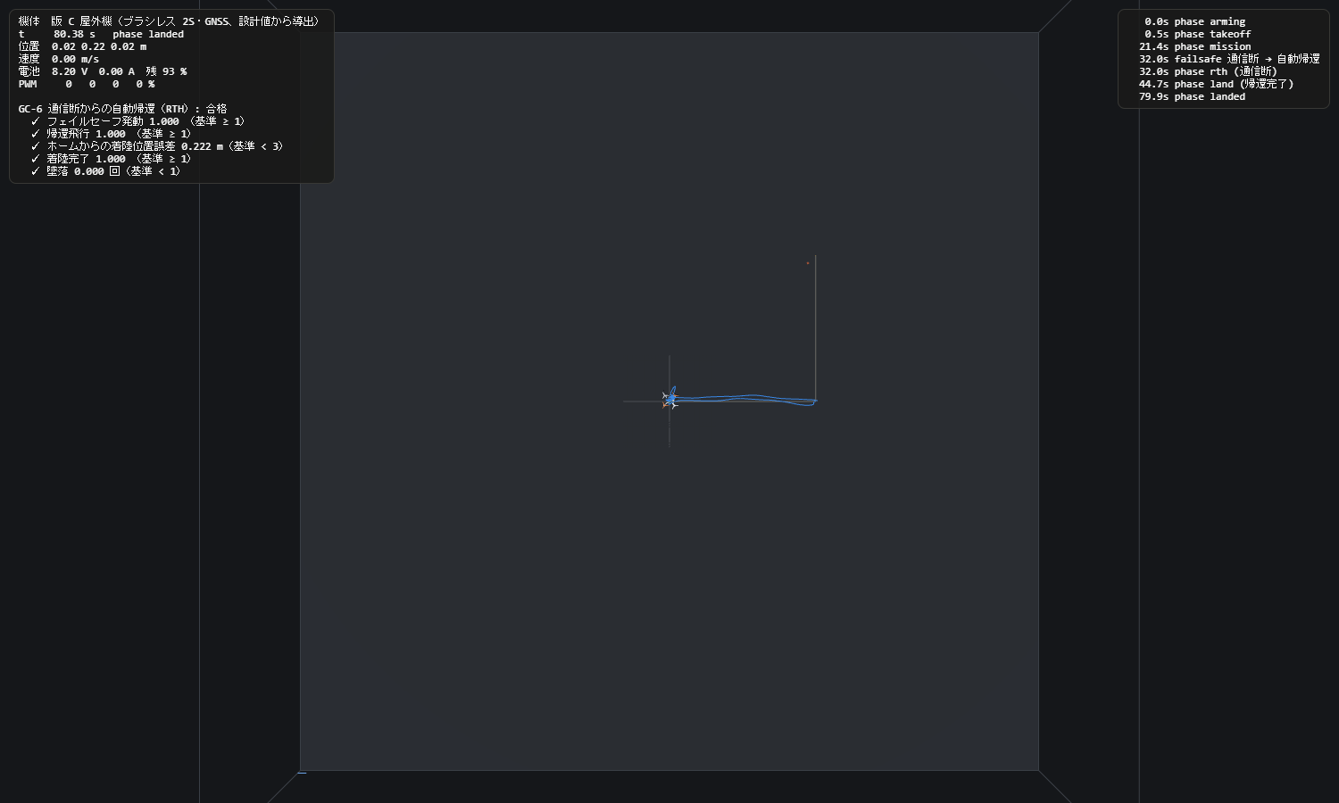
reports/img/variantC-rth-top.png
