TakaI2/Drone_simulate/reports/img/variantC-side.png

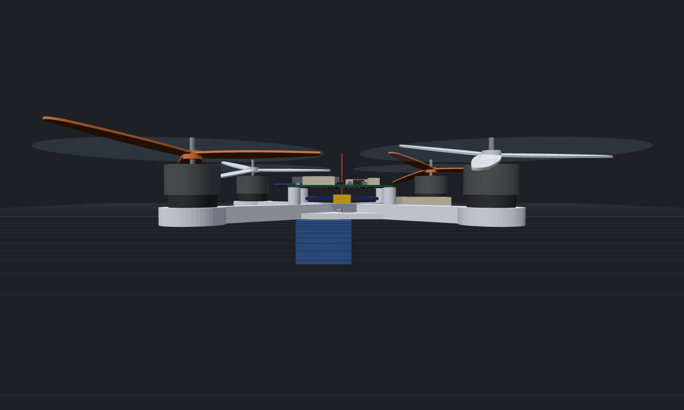
reports/img/variantC-side.png
