TakaI2/Drone_simulate/out/variantC/bom.csv

Refs | Qty | Name | Value | MPN | Manufacturer | Package | UnitMass_g | Alternatives | Verify | Search
C1 C2 | 2 | 積層セラミックコンデンサ 10 µF 25 V X5R 0805 | 10 µF | GRM21BR61E106KA73L | Murata | C0805 | 0.012 | Samsung Electro-Mechanics CL シリーズ同等品 / TDK C シリーズ同等品 |  | https://www.digikey.jp/ja/products/result?keywords=GRM21BR61E106KA73L
C3 C7 C9 C10 C11 C12 C13 | 7 | 積層セラミックコンデンサ 100 nF 16 V X7R 0603 | 100 nF | GRM188R71C104KA01D | Murata | C0603 | 0.005 | Samsung Electro-Mechanics CL シリーズ同等品 / TDK C シリーズ同等品 |  | https://www.digikey.jp/ja/products/result?keywords=GRM188R71C104KA01D
C4 C5 C6 | 3 | 積層セラミックコンデンサ 10 µF 10 V X5R 0805 | 10 µF | GRM21BR61A106KE19L | Murata | C0805 | 0.012 | Samsung Electro-Mechanics CL シリーズ同等品 / TDK C シリーズ同等品 |  | https://www.digikey.jp/ja/products/result?keywords=GRM21BR61A106KE19L
C8 | 1 | 積層セラミックコンデンサ 1 µF 10 V X5R 0603 | 1 µF | GRM188R61A105KA61D | Murata | C0603 | 0.005 | Samsung Electro-Mechanics CL シリーズ同等品 / TDK C シリーズ同等品 |  | https://www.digikey.jp/ja/products/result?keywords=GRM188R61A105KA61D
D1 | 1 | ショットキーダイオード 40 V 1 A（モータ還流用） | B5819W | B5819W | 各社（汎用品） | SOD-123 | 0.01 | 各社 SS14 / onsemi MBR0540 |  | https://www.digikey.jp/ja/products/result?keywords=B5819W
D2 | 1 | チップ LED 赤 0603(1608) | APT1608EC | APT1608EC | Kingbright | LED0603 | 0.003 | ROHM SML-D12U1W |  | https://www.digikey.jp/ja/products/result?keywords=APT1608EC
H1 H2 H3 H4 | 4 | M2 取付穴 | — | — | — | MountHole-M2 | 0
J1 | 1 | 4-in-1 ESC ハーネス用 JST SH 8 ピン（SMD） | SM08B-SRSS-TB(LF)(SN) | SM08B-SRSS-TB(LF)(SN) | J.S.T. Mfg. | JST-SH-8-SMD | 0.1 | 各社 SH 互換 1.0 mm 8P | ESC 付属ハーネスのピン順（製品ごとに異なる。VBAT/GND/CURR/M1–M4/TLM で配線） | https://www.digikey.jp/ja/products/result?keywords=SM08B-SRSS-TB(LF)(SN)
J2 | 1 | フロー＋ToF モジュール用 JST SH 8 ピン（SMD） | SM08B-SRSS-TB(LF)(SN) | SM08B-SRSS-TB(LF)(SN) | J.S.T. Mfg. | JST-SH-8-SMD | 0.1 | 各社 SH 互換 1.0 mm 8P |  | https://www.digikey.jp/ja/products/result?keywords=SM08B-SRSS-TB(LF)(SN)
J3 | 1 | 書込み用テストパッド 1×6（1.27 mm、ポゴピン治具で接触） | — | — | — | TestPad-1x6-1.27 | 0 | 各社 2.54 mm ピンヘッダ 1×6
J4 | 1 | GNSS＋コンパス用 JST SH 6 ピン（SMD） | SM06B-SRSS-TB(LF)(SN) | SM06B-SRSS-TB(LF)(SN) | J.S.T. Mfg. | JST-SH-6-SMD | 0.08 | 各社 SH 互換 1.0 mm 6P |  | https://www.digikey.jp/ja/products/result?keywords=SM06B-SRSS-TB(LF)(SN)
L1 | 1 | SMD パワーインダクタ 10 µH（4×4×2 mm） | 10 µH | SWPA4020S100MT | Sunlord | L-Power-4x4 | 0.12 | Taiyo Yuden NR4018T100M / Murata LQH44PN100MP0 | 飽和電流・直流抵抗（シリーズにより差がある） | https://www.digikey.jp/ja/products/result?keywords=SWPA4020S100MT
R1 R3 R8 | 3 | チップ抵抗 100kΩ 1% 0603(1608) | 100kΩ | RC0603FR-07100KL | Yageo | R0603 | 0.002 | Panasonic ERJ-3EKF100KV 相当 / KOA RK73H1JTTD 相当 |  | https://www.digikey.jp/ja/products/result?keywords=RC0603FR-07100KL
R2 | 1 | チップ抵抗 33kΩ 1% 0603(1608) | 33kΩ | RC0603FR-0733KL | Yageo | R0603 | 0.002 | Panasonic ERJ-3EKF33KV 相当 / KOA RK73H1JTTD 相当 |  | https://www.digikey.jp/ja/products/result?keywords=RC0603FR-0733KL
R4 R5 R9 | 3 | チップ抵抗 10kΩ 1% 0603(1608) | 10kΩ | RC0603FR-0710KL | Yageo | R0603 | 0.002 | Panasonic ERJ-3EKF10KV 相当 / KOA RK73H1JTTD 相当 |  | https://www.digikey.jp/ja/products/result?keywords=RC0603FR-0710KL
R6 R7 | 2 | チップ抵抗 4.7kΩ 1% 0603(1608) | 4.7kΩ | RC0603FR-074K7L | Yageo | R0603 | 0.002 | Panasonic ERJ-3EKF4K7V 相当 / KOA RK73H1JTTD 相当 |  | https://www.digikey.jp/ja/products/result?keywords=RC0603FR-074K7L
R10 | 1 | チップ抵抗 1kΩ 1% 0603(1608) | 1kΩ | RC0603FR-071KL | Yageo | R0603 | 0.002 | Panasonic ERJ-3EKF1KV 相当 / KOA RK73H1JTTD 相当 |  | https://www.digikey.jp/ja/products/result?keywords=RC0603FR-071KL
SW1 SW2 | 2 | タクトスイッチ 3×4 mm（SMD） | TS-1187A-B-A-B | TS-1187A-B-A-B | XKB Connection | Tact-3x4-SMD | 0.05 | Alps Alpine SKRPACE010 |  | https://www.digikey.jp/ja/products/result?keywords=TS-1187A-B-A-B
U1 | 1 | 降圧 DC-DC コンバータ 1.2 A（4.5〜24 V 入力、非同期整流） | MP2359DJ-LF-Z | MP2359DJ-LF-Z | Monolithic Power Systems | SOT-23-6 | 0.015 | Aerosemi / Silergy MT2492 / SY8201 系 / Texas Instruments TPS560430 | ピン配置（1 BST / 2 GND / 3 FB / 4 EN / 5 IN / 6 SW）、EN 端子の最大定格、推奨インダクタ値 | https://www.digikey.jp/ja/products/result?keywords=MP2359DJ-LF-Z
U2 | 1 | Wi-Fi/BLE マイコンモジュール ESP32-S3（8MB Flash, PSRAM なし） | ESP32-S3-WROOM-1-N8 | ESP32-S3-WROOM-1-N8 | Espressif Systems | ESP32-S3-WROOM-1 | 3 | Espressif Systems ESP32-S3-MINI-1-N8 / M5Stack M5Stamp S3 / STMicroelectronics STM32F405 + 外付け無線 | モジュール寸法とパッド位置（1.27 mm ピッチ）、アンテナ禁止領域 | https://www.digikey.jp/ja/products/result?keywords=ESP32-S3-WROOM-1-N8
U3 | 1 | 6軸 IMU（ジャイロ＋加速度） | ICM-42688-P | ICM-42688-P | TDK InvenSense | LGA-14-2.5x3 | 0.02 | Bosch Sensortec BMI270 / STMicroelectronics LSM6DSO | ピン番号と RESV ピンの処理、推奨デカップリング容量 | https://www.digikey.jp/ja/products/result?keywords=ICM-42688-P
U4 | 1 | 気圧センサ | BMP390 | BMP390 | Bosch Sensortec | LGA-10-2x2 | 0.01 | Infineon DPS310 / STMicroelectronics LPS22HB | ピン配置と通気穴の向き | https://www.digikey.jp/ja/products/result?keywords=BMP390
