TakaI2/Drone_simulate/out/parts3d/VL53L1X-LGA12.stl

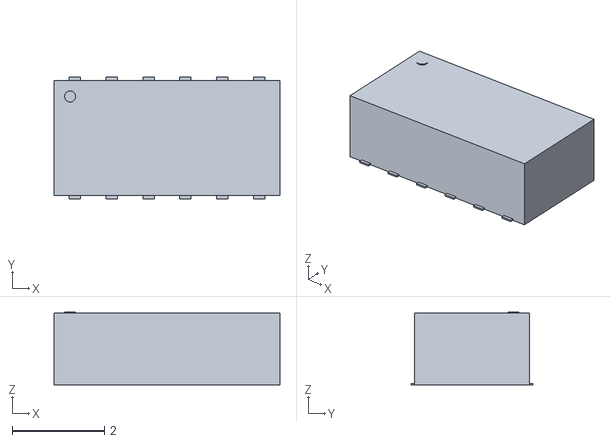
[picture p35: CAD file, 2026-09-27]
out/parts3d/VL53L1X-LGA12.stl
4.90 x 2.65 x 1.58
