TakaI2/Drone_simulate/out/stage4/frame.stl

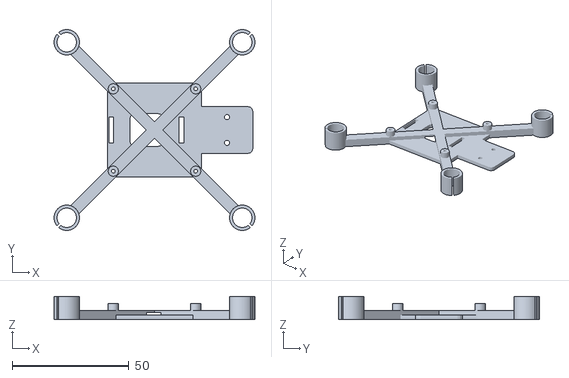
[picture p36: CAD file, 2026-09-27]
out/stage4/frame.stl
85.9 x 85.9 x 10.0
