TakaI2/Drone_simulate/out/variantB/frame.stl

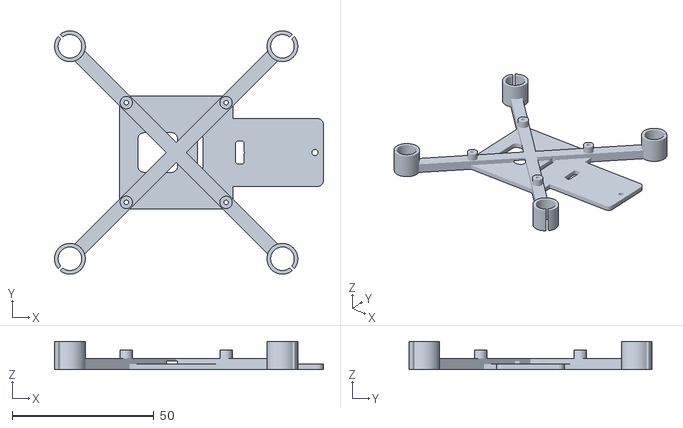
[picture p37: CAD file, 2026-09-27]
out/variantB/frame.stl
95.0 x 85.9 x 10.0
