TakaI2/Drone_simulate/out/variantC/frame.stl

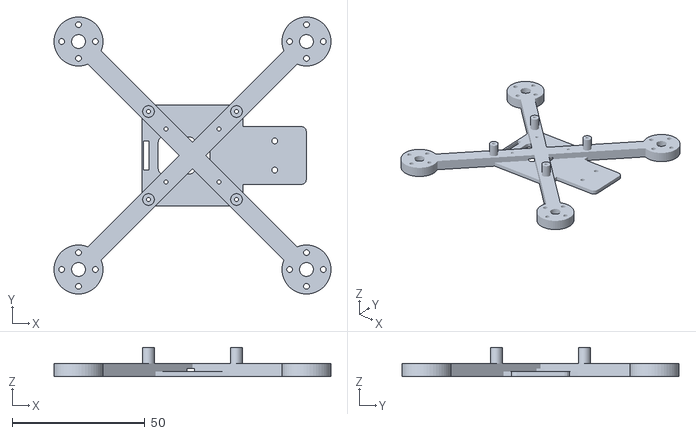
[picture p38: CAD file, 2026-09-27]
out/variantC/frame.stl
104.5 x 104.5 x 11.0
