TakaI2/Drone_simulate/out/parts3d/PMW3901MB.stl

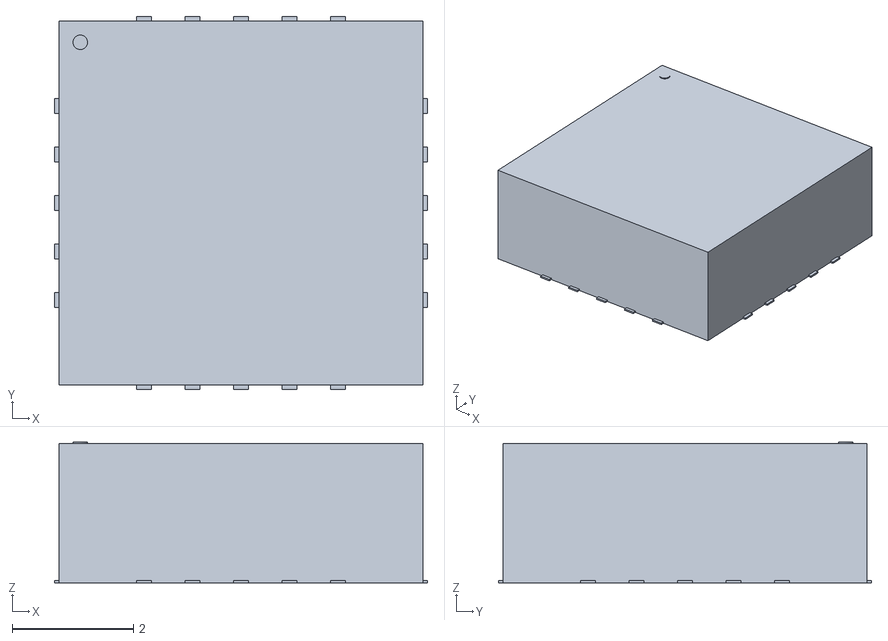
[picture p39: CAD file, 2026-09-27]
out/parts3d/PMW3901MB.stl
6.15 x 6.15 x 2.32
