TakaI2/Drone_simulate/out/parts3d/JST-SH-6-SMD.stl

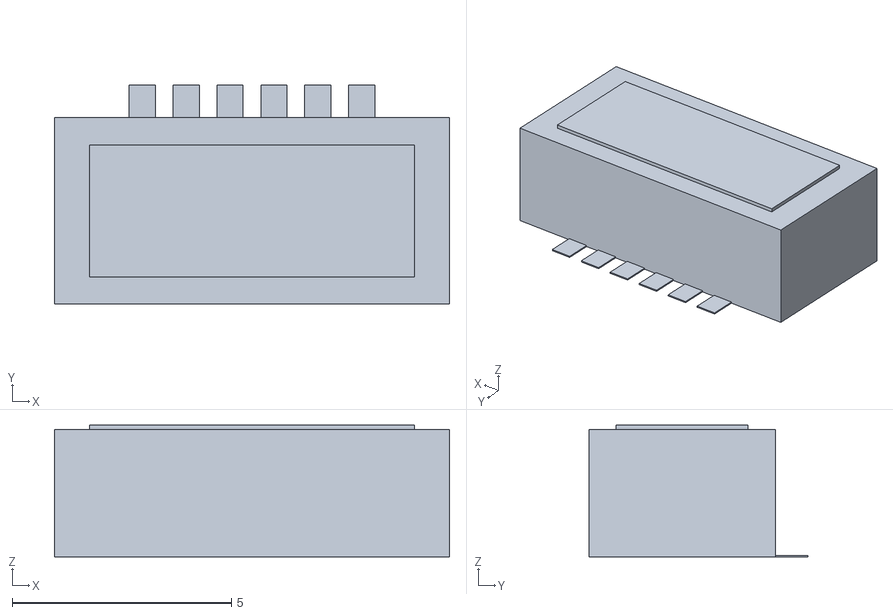
[picture p40: CAD file, 2026-09-27]
out/parts3d/JST-SH-6-SMD.stl
9.00 x 5.00 x 3.00
