TakaI2/Drone_simulate/out/parts3d/QFN-32-5x5.stl

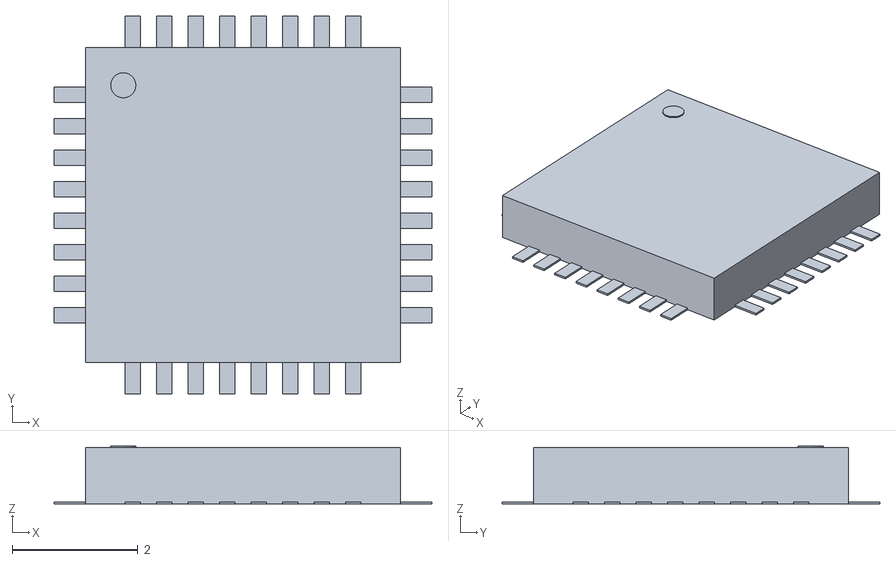
[picture p41: CAD file, 2026-09-26]
out/parts3d/QFN-32-5x5.stl
6.00 x 6.00 x 0.92
