TakaI2/Drone_simulate/out/parts3d/TO-92.stl

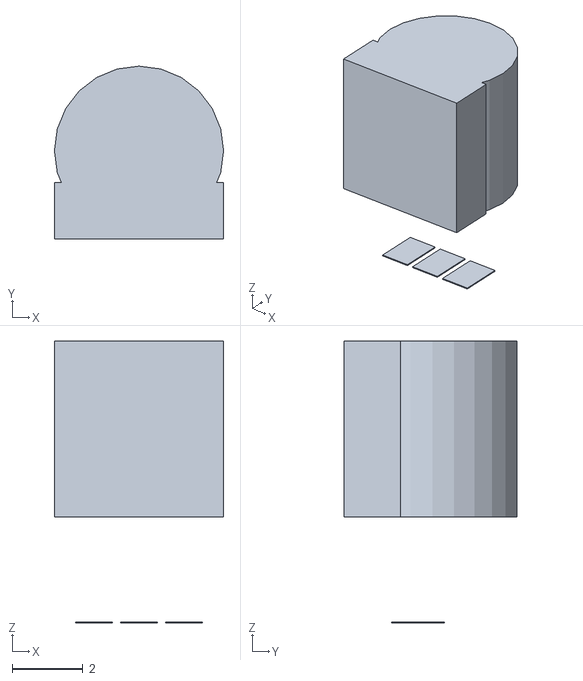
[picture p42: CAD file, 2026-09-26]
out/parts3d/TO-92.stl
4.80 x 4.90 x 8.00
