TakaI2/Drone_simulate/out/parts3d/ESP32-S3-WROOM-1.stl

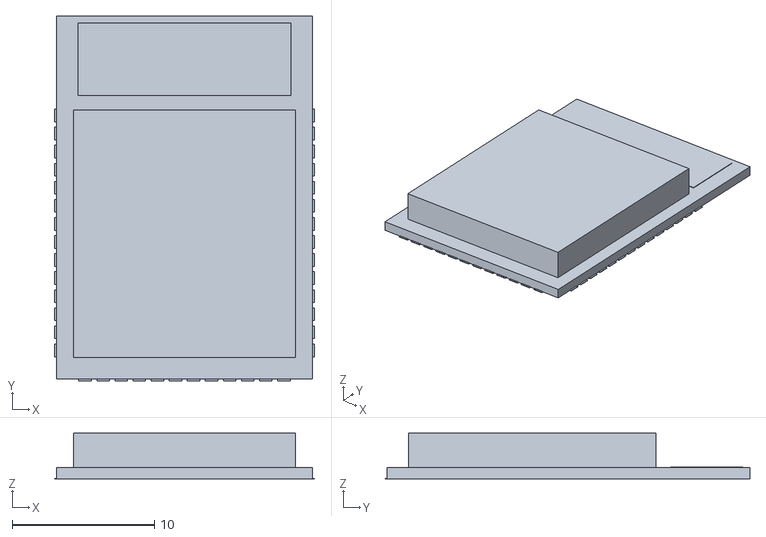
[picture p43: CAD file, 2026-09-26]
out/parts3d/ESP32-S3-WROOM-1.stl
18.3 x 25.6 x 3.20
