TakaI2/Drone_simulate/out/parts3d/L-Power-4x4.stl

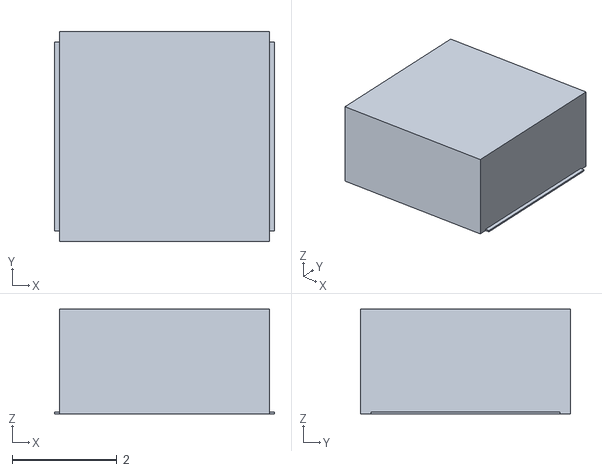
[picture p44: CAD file, 2026-09-26]
out/parts3d/L-Power-4x4.stl
4.20 x 4.00 x 2.00
