TakaI2/Drone_simulate/out/parts3d/DIP-8.stl

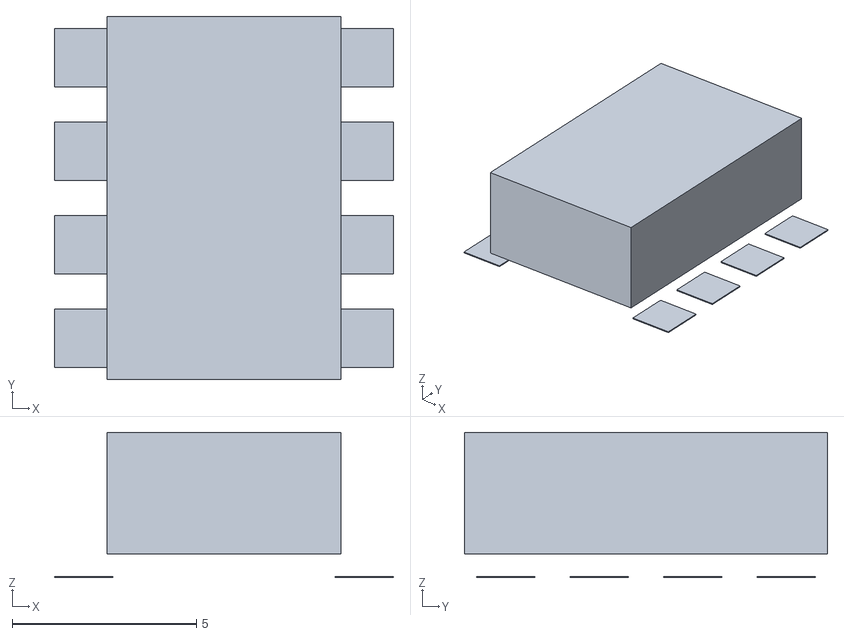
[picture p45: CAD file, 2026-09-26]
out/parts3d/DIP-8.stl
9.22 x 9.86 x 3.95
