TakaI2/Drone_simulate/out/parts3d/Axial-R-10.16.stl

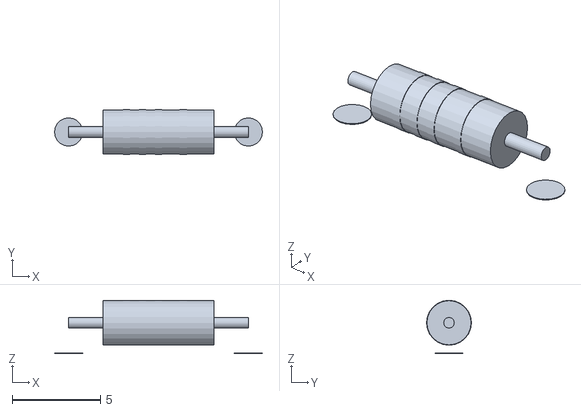
[picture p46: CAD file, 2026-09-26]
out/parts3d/Axial-R-10.16.stl
11.8 x 2.54 x 3.02
