TakaI2/Drone_simulate/out/parts3d/C0805.stl

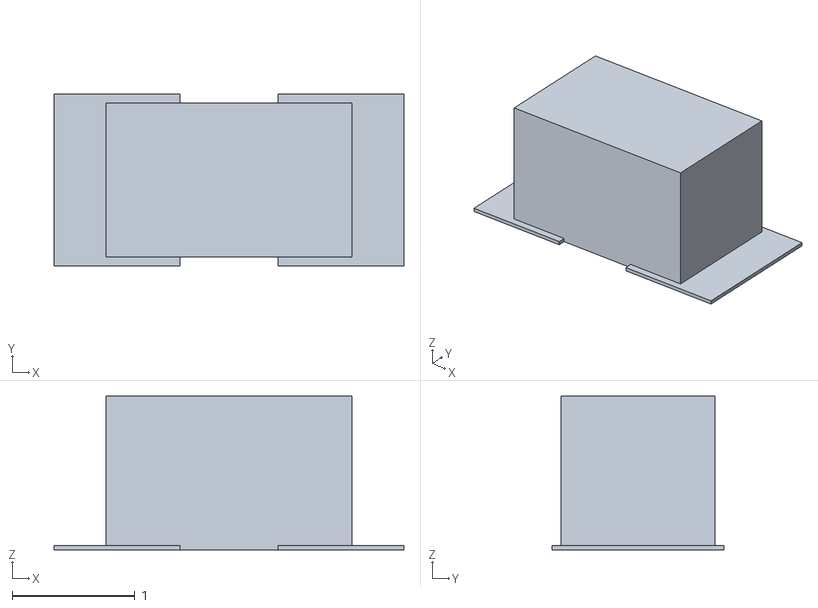
[picture p47: CAD file, 2026-09-26]
out/parts3d/C0805.stl
2.85 x 1.40 x 1.25
