TakaI2/Drone_simulate/out/parts3d/PinHeader-2x5-2.54.stl

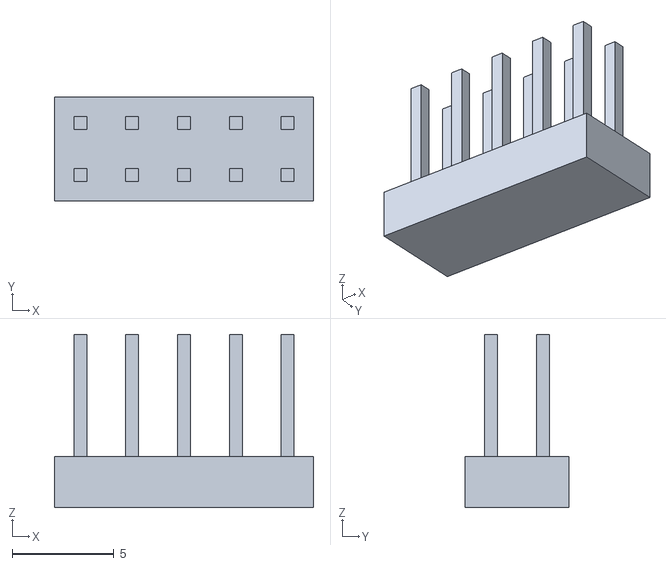
[picture p48: CAD file, 2026-09-26]
out/parts3d/PinHeader-2x5-2.54.stl
12.7 x 5.08 x 8.50
