TakaI2/Drone_simulate/out/parts3d/SOT-23.stl

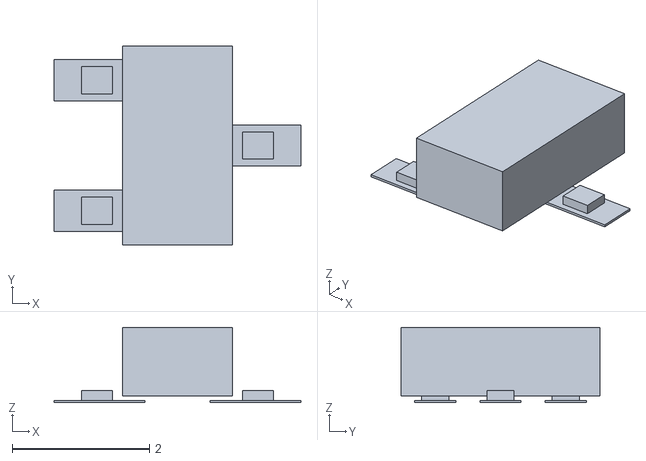
[picture p49: CAD file, 2026-09-26]
out/parts3d/SOT-23.stl
3.60 x 2.90 x 1.10
