TakaI2/Drone_simulate/out/parts3d/BatteryPad-2.stl

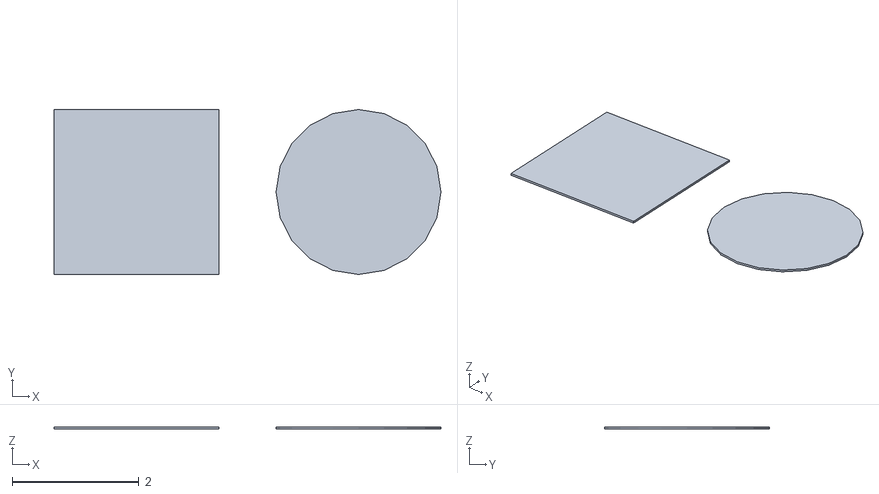
[picture p50: CAD file, 2026-09-26]
out/parts3d/BatteryPad-2.stl
6.10 x 2.60 x 0.035
