TakaI2/Drone_simulate/out/parts3d/DIP-16.stl

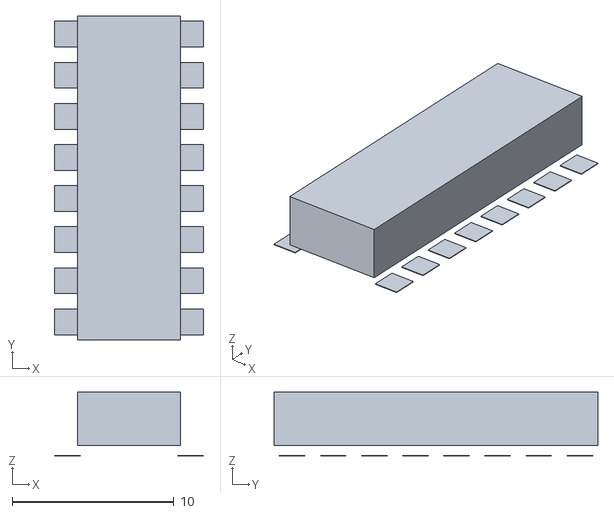
[picture p51: CAD file, 2026-09-26]
out/parts3d/DIP-16.stl
9.22 x 20.0 x 3.95
