TakaI2/Drone_simulate/out/parts3d/L0603.stl

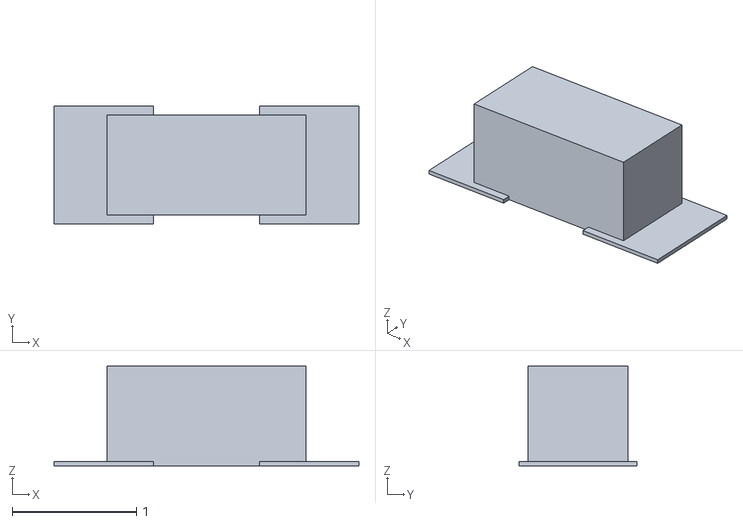
[picture p52: CAD file, 2026-09-26]
out/parts3d/L0603.stl
2.45 x 0.95 x 0.8
