TakaI2/Drone_simulate/out/parts3d/SOT-223.stl

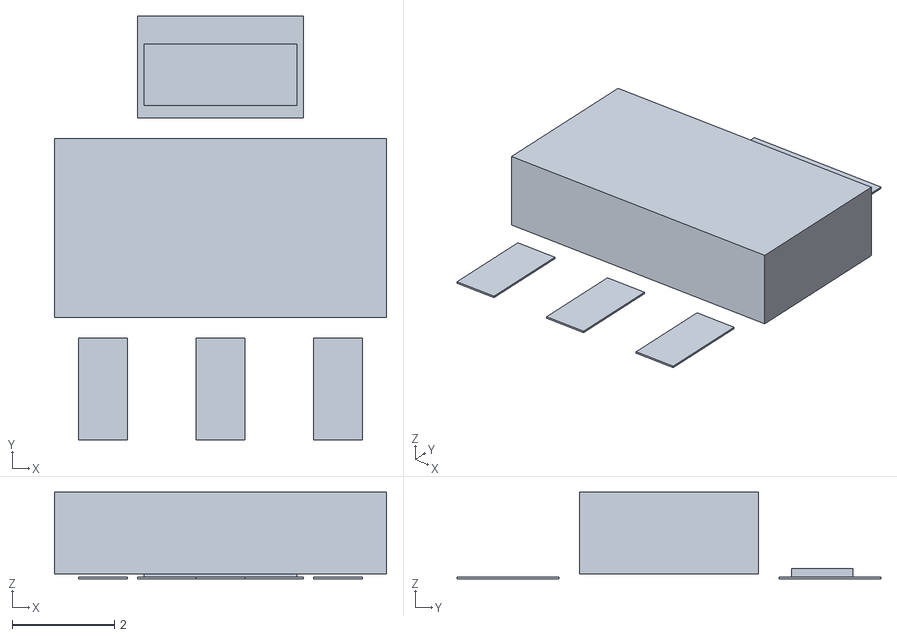
[picture p54: CAD file, 2026-09-26]
out/parts3d/SOT-223.stl
6.50 x 8.30 x 1.70
