TakaI2/Drone_simulate/out/parts3d/HC-49S.stl

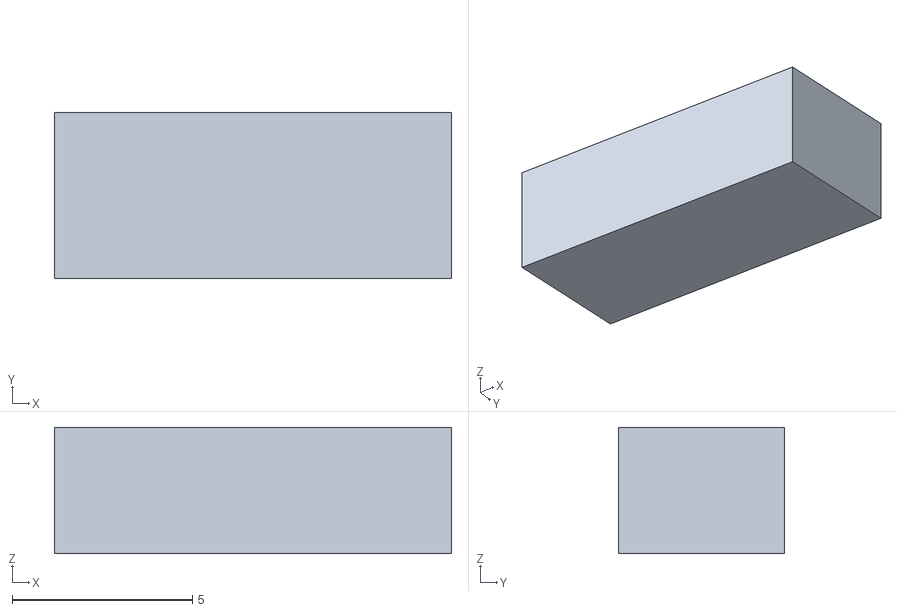
[picture p55: CAD file, 2026-09-26]
out/parts3d/HC-49S.stl
11.0 x 4.60 x 3.50
