TakaI2/Drone_simulate/out/parts3d/CP-Radial-D8-H12.stl

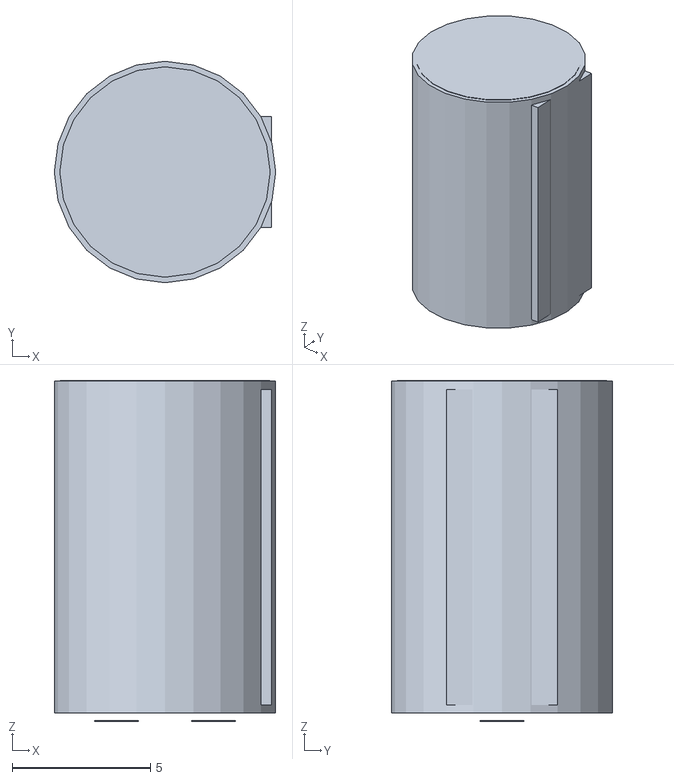
[picture p56: CAD file, 2026-09-26]
out/parts3d/CP-Radial-D8-H12.stl
8.00 x 8.00 x 12.3
