TakaI2/Drone_simulate/out/parts3d/C1210.stl

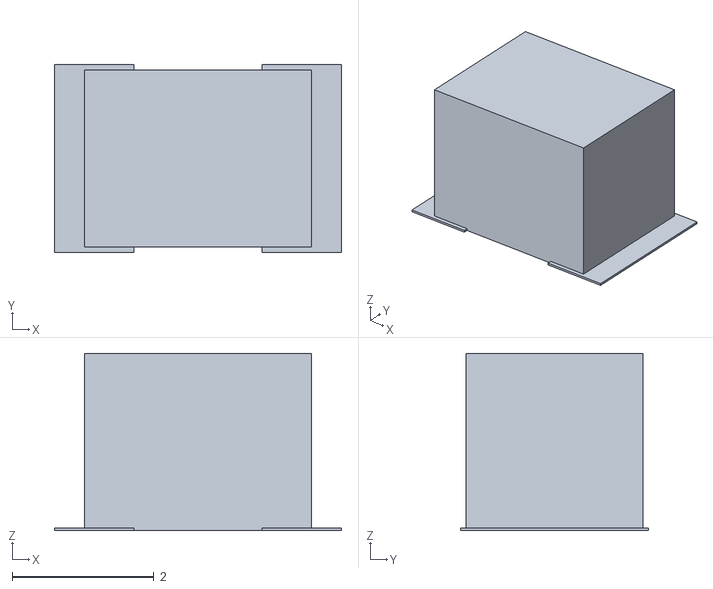
[picture p57: CAD file, 2026-09-26]
out/parts3d/C1210.stl
4.05 x 2.65 x 2.50
