TakaI2/Drone_simulate/out/parts3d/PinHeader-1x6-2.54.stl

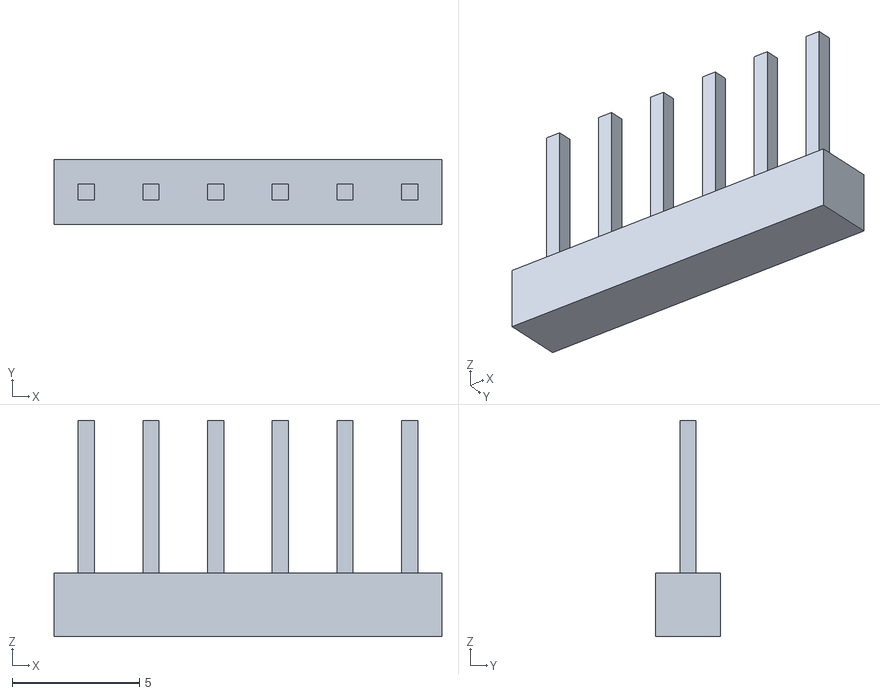
[picture p58: CAD file, 2026-09-26]
out/parts3d/PinHeader-1x6-2.54.stl
15.2 x 2.54 x 8.50
