TakaI2/Drone_simulate/out/parts3d/LGA-14-2.5x3.stl

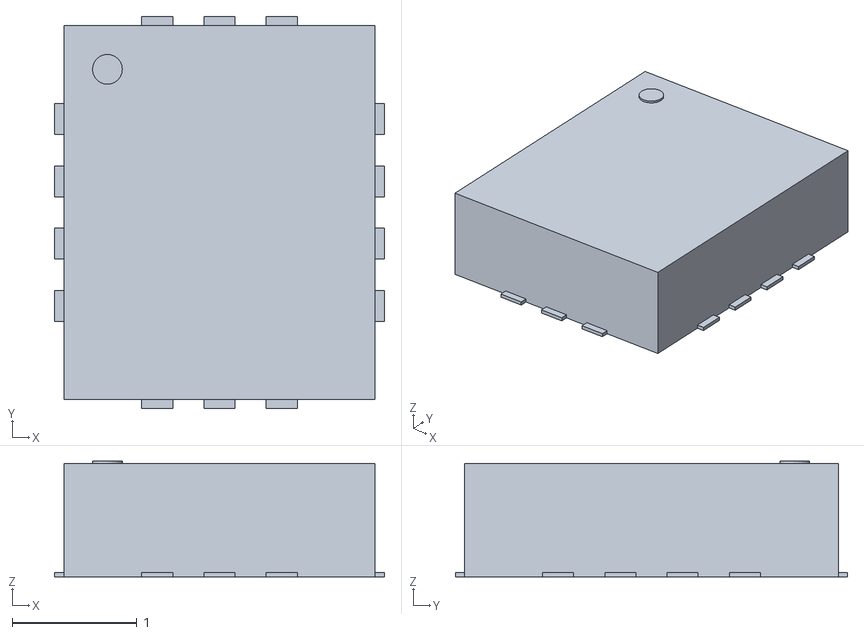
[picture p59: CAD file, 2026-09-26]
out/parts3d/LGA-14-2.5x3.stl
2.65 x 3.15 x 0.93
