TakaI2/Drone_simulate/out/parts3d/DO-41.stl

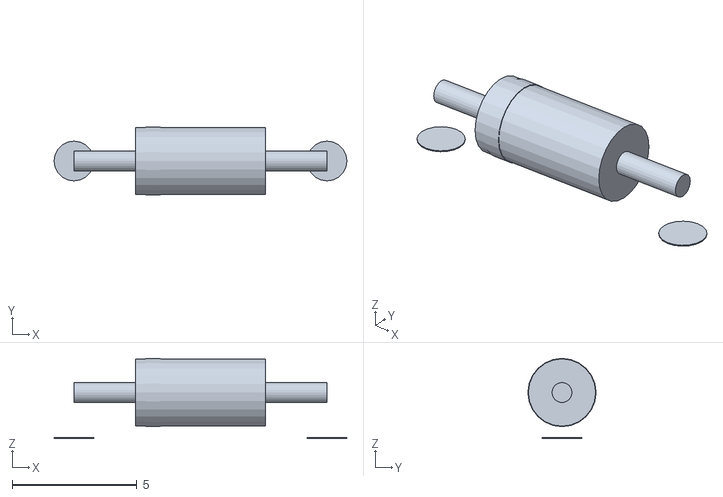
[picture p60: CAD file, 2026-09-26]
out/parts3d/DO-41.stl
11.8 x 2.74 x 3.22
