TakaI2/Drone_simulate/out/parts3d/SOD-123.stl

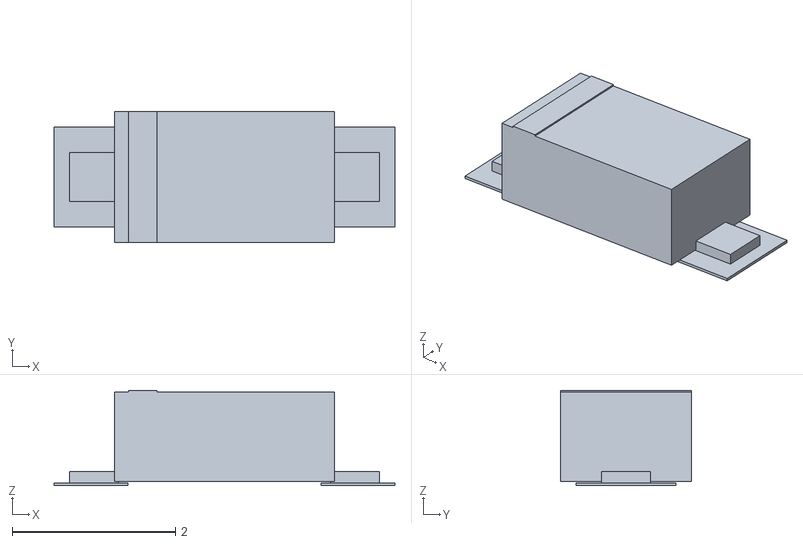
[picture p62: CAD file, 2026-09-26]
out/parts3d/SOD-123.stl
4.18 x 1.60 x 1.17
