TakaI2/Drone_simulate/out/parts3d/JST-PH-2-THT.stl

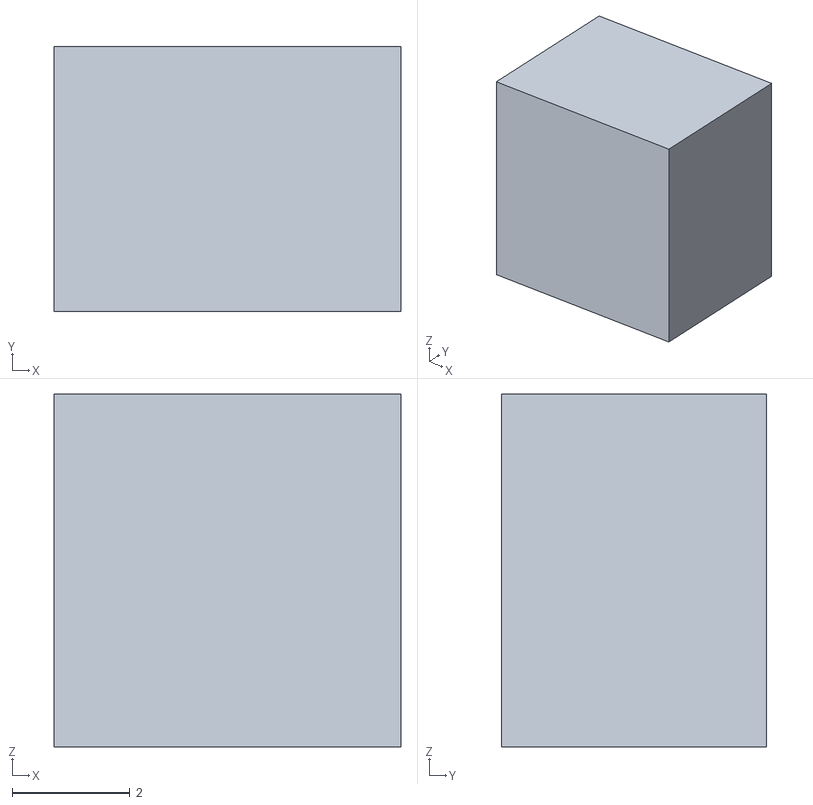
[picture p63: CAD file, 2026-09-26]
out/parts3d/JST-PH-2-THT.stl
5.90 x 4.50 x 6.00
