TakaI2/Drone_simulate/out/parts3d/R0603.stl

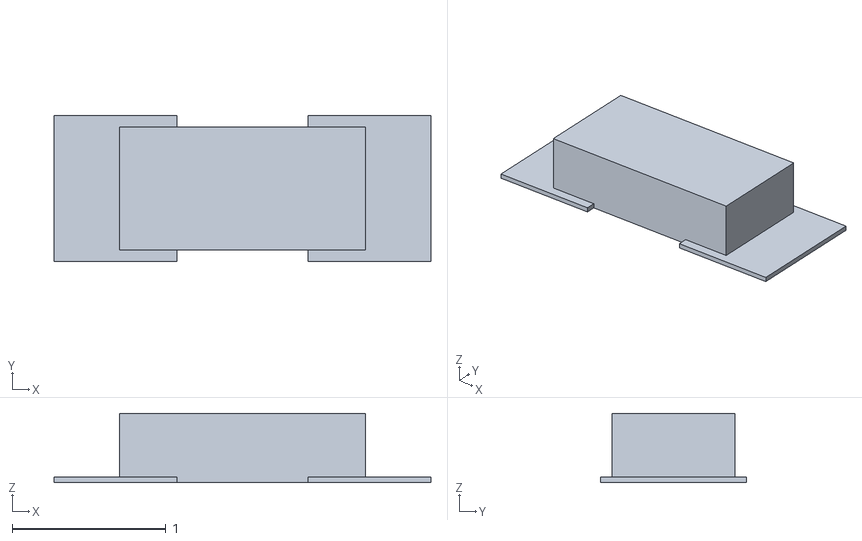
[picture p64: CAD file, 2026-09-26]
out/parts3d/R0603.stl
2.45 x 0.95 x 0.45
