TakaI2/Drone_simulate/out/parts3d/TO-220-3.stl

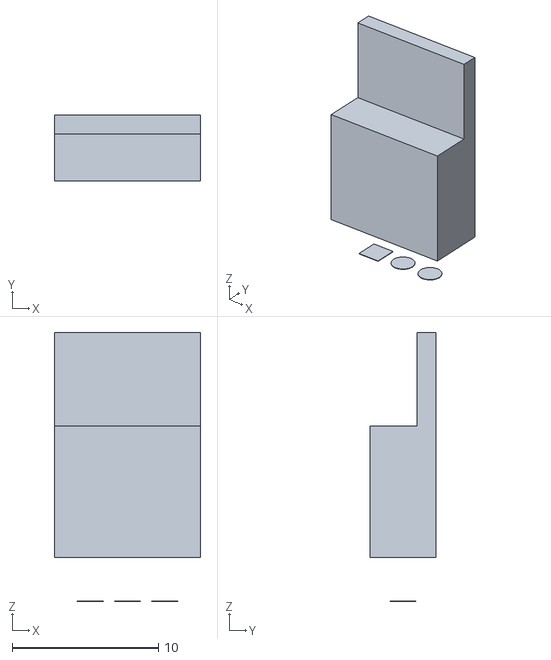
[picture p65: CAD file, 2026-09-26]
out/parts3d/TO-220-3.stl
10.0 x 4.50 x 18.4
