TakaI2/Drone_simulate/out/parts3d/JST-SH-8-SMD.stl

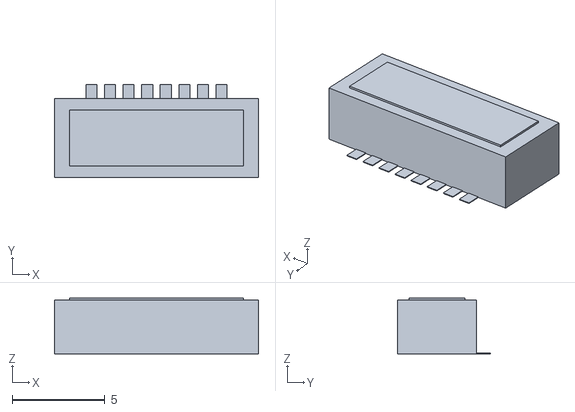
[picture p66: CAD file, 2026-09-26]
out/parts3d/JST-SH-8-SMD.stl
11.0 x 5.00 x 3.00
