TakaI2/Drone_simulate/out/parts3d/R0402.stl

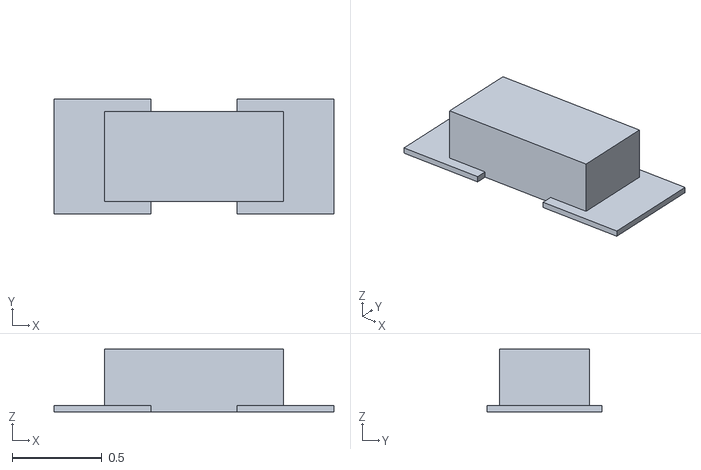
[picture p67: CAD file, 2026-09-26]
out/parts3d/R0402.stl
1.56 x 0.64 x 0.35
