TakaI2/Drone_simulate/out/parts3d/R0805.stl

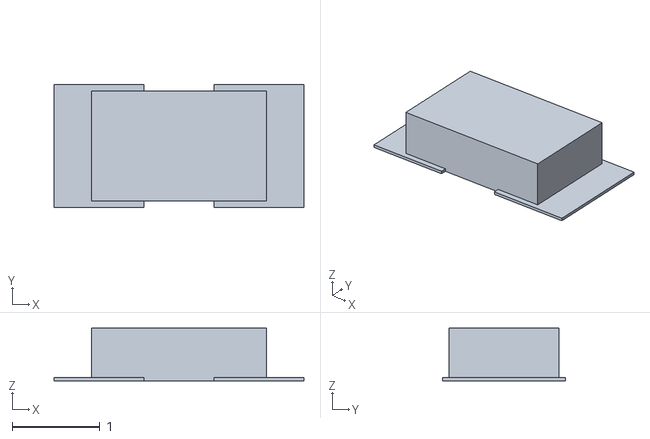
[picture p68: CAD file, 2026-09-26]
out/parts3d/R0805.stl
2.85 x 1.40 x 0.6
