TakaI2/Drone_simulate/out/parts3d/SOIC-14.stl

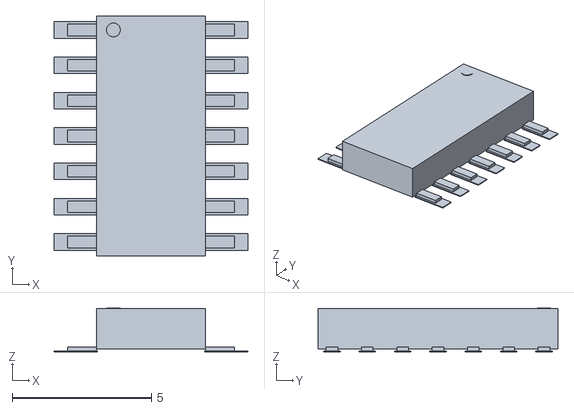
[picture p69: CAD file, 2026-09-26]
out/parts3d/SOIC-14.stl
6.95 x 8.62 x 1.57
