TakaI2/Drone_simulate/out/parts3d/JST-SH-4-SMD.stl

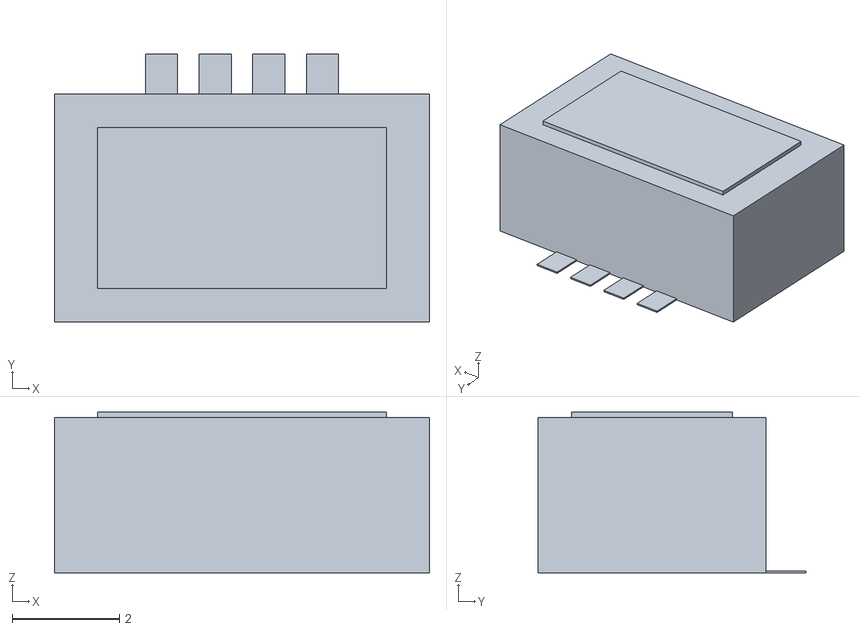
[picture p70: CAD file, 2026-09-26]
out/parts3d/JST-SH-4-SMD.stl
7.00 x 5.00 x 3.00
