TakaI2/Drone_simulate/out/parts3d/SOIC-8.stl

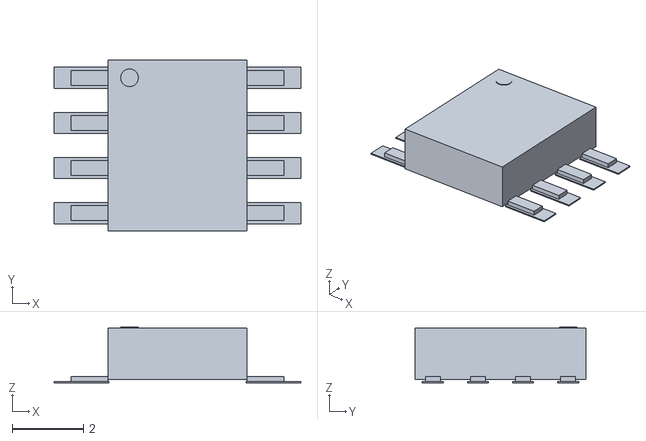
[picture p71: CAD file, 2026-09-26]
out/parts3d/SOIC-8.stl
6.95 x 4.81 x 1.57
