TakaI2/Drone_simulate/out/parts3d/R1206.stl

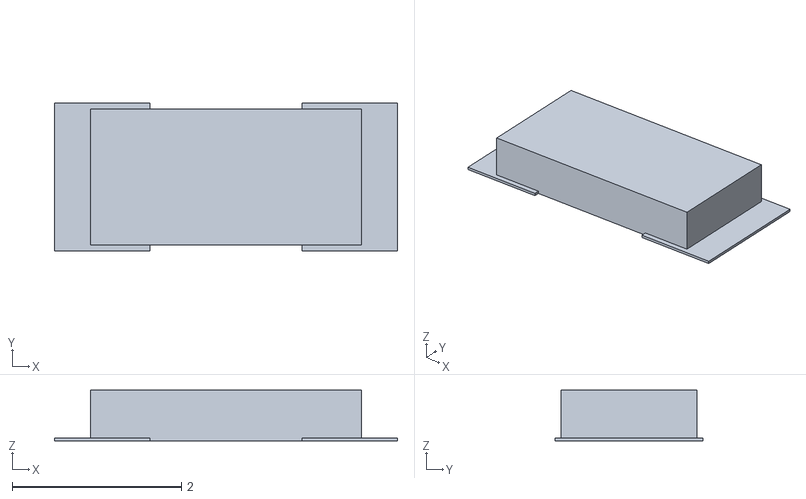
[picture p72: CAD file, 2026-09-26]
out/parts3d/R1206.stl
4.05 x 1.75 x 0.6
