TakaI2/Drone_simulate/out/parts3d/C-Disc-D5.stl

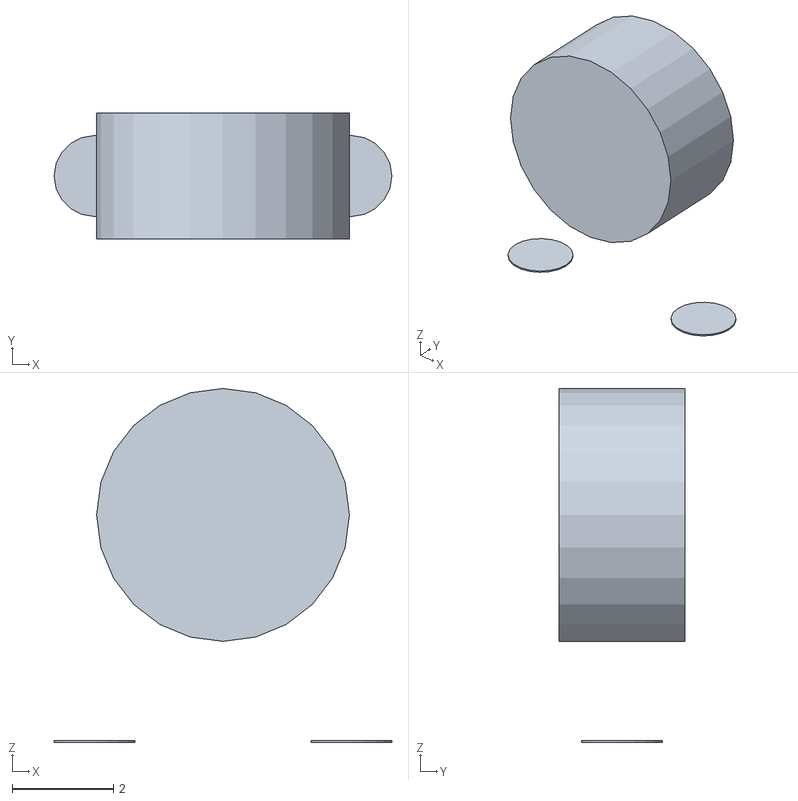
[picture p73: CAD file, 2026-09-26]
out/parts3d/C-Disc-D5.stl
6.68 x 2.50 x 7.00
