TakaI2/Drone_simulate/out/parts3d/TestPad-1x6-1.27.stl

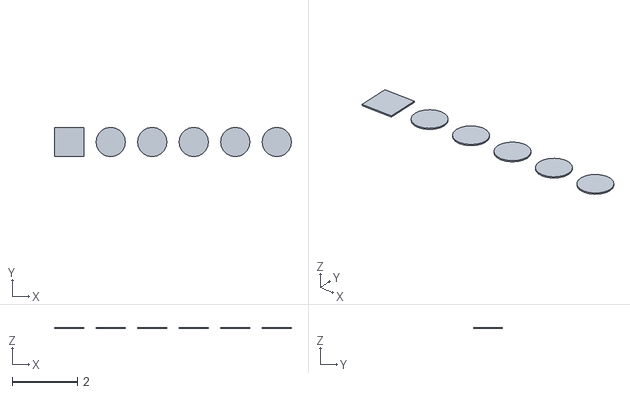
[picture p74: CAD file, 2026-09-26]
out/parts3d/TestPad-1x6-1.27.stl
7.25 x 0.9 x 0.035
