TakaI2/Drone_simulate/out/parts3d/SOT-23-5.stl

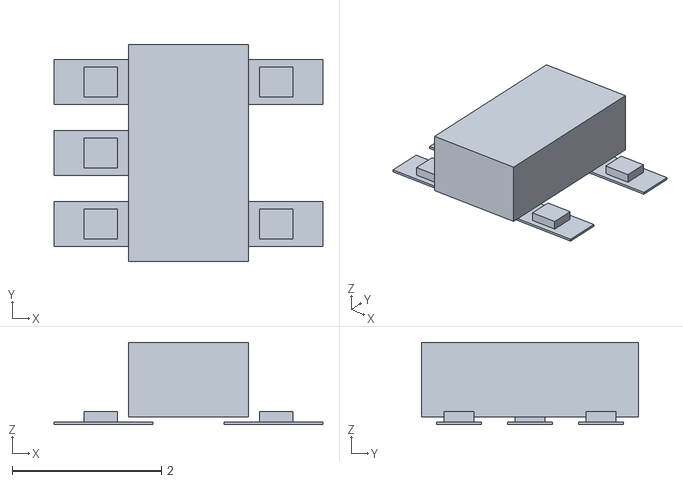
[picture p75: CAD file, 2026-09-26]
out/parts3d/SOT-23-5.stl
3.60 x 2.90 x 1.10
