TakaI2/Drone_simulate/out/parts3d/LED0603.stl

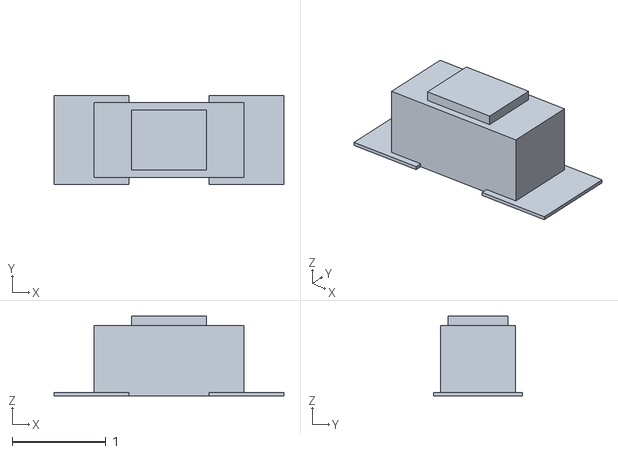
[picture p76: CAD file, 2026-09-26]
out/parts3d/LED0603.stl
2.45 x 0.95 x 0.85
