TakaI2/Drone_simulate/out/parts3d/LED-5mm.stl

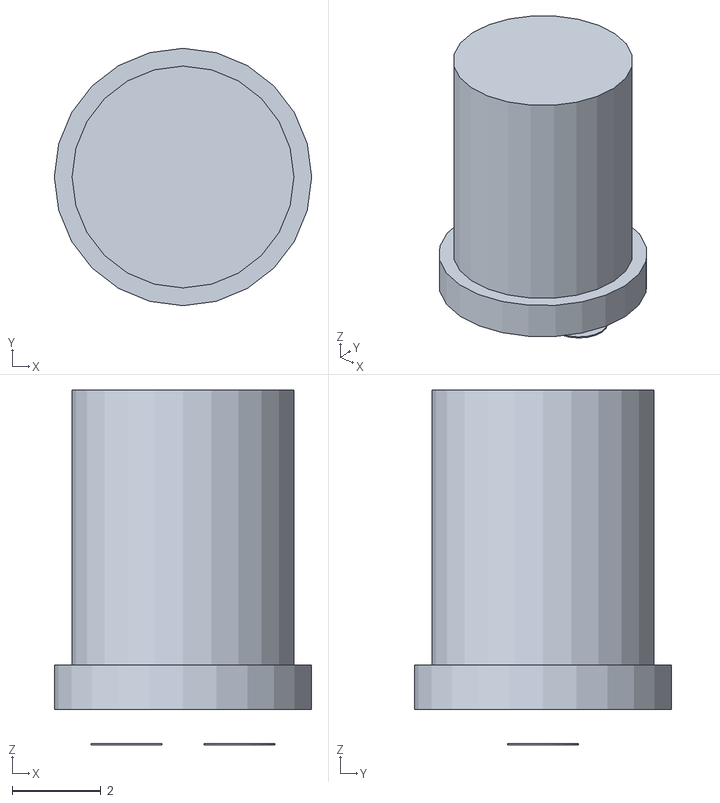
[picture p78: CAD file, 2026-09-26]
out/parts3d/LED-5mm.stl
5.80 x 5.80 x 8.00
