TakaI2/Drone_simulate/out/parts3d/LGA-10-2x2.stl

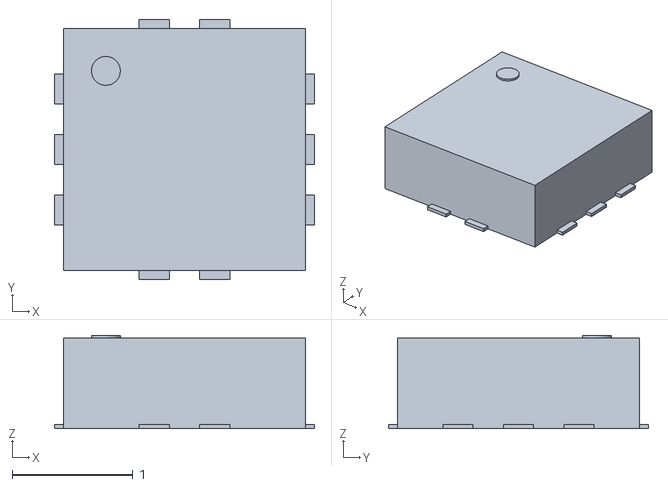
[picture p79: CAD file, 2026-09-26]
out/parts3d/LGA-10-2x2.stl
2.15 x 2.15 x 0.77
