TakaI2/Drone_simulate/out/parts3d/C1206.stl

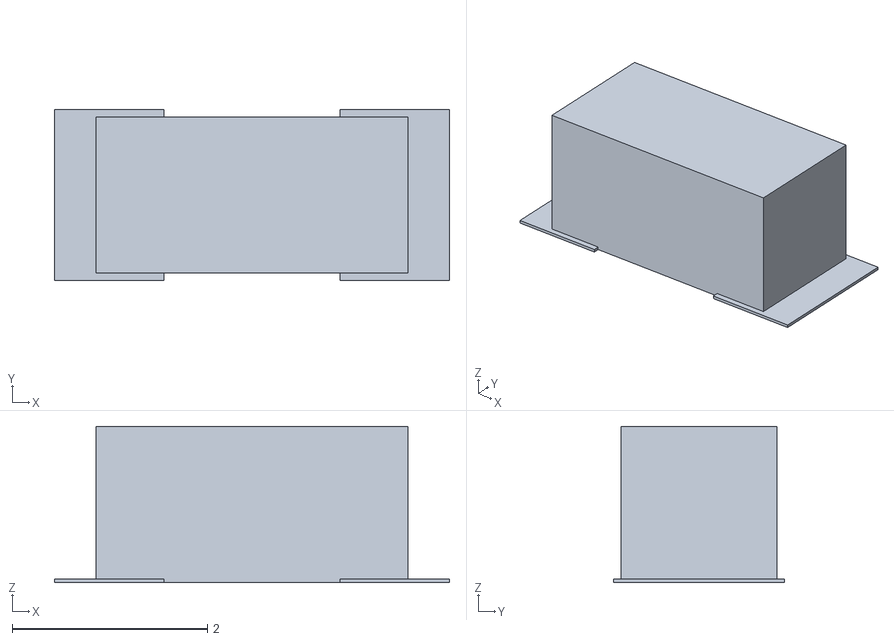
[picture p80: CAD file, 2026-09-26]
out/parts3d/C1206.stl
4.05 x 1.75 x 1.60
