TakaI2/Drone_simulate/out/parts3d/MotorPad-2.stl

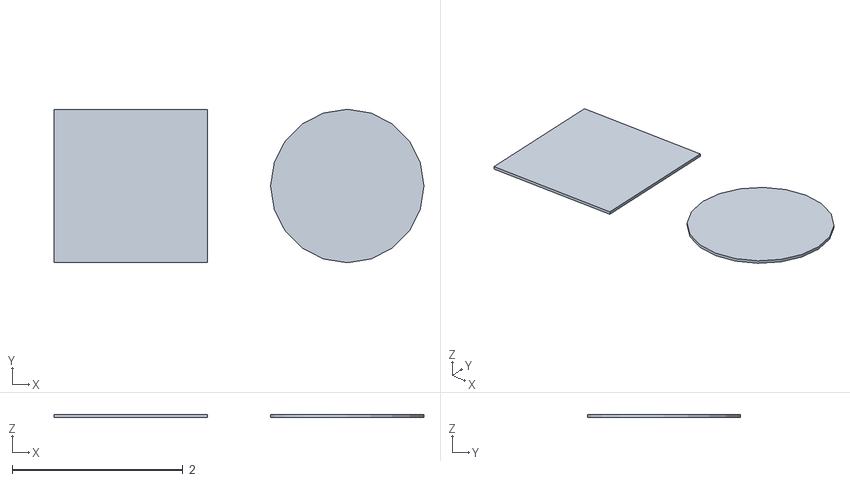
[picture p81: CAD file, 2026-09-26]
out/parts3d/MotorPad-2.stl
4.34 x 1.80 x 0.035
