TakaI2/Drone_simulate/out/parts3d/CP-Radial-D5-H11.stl

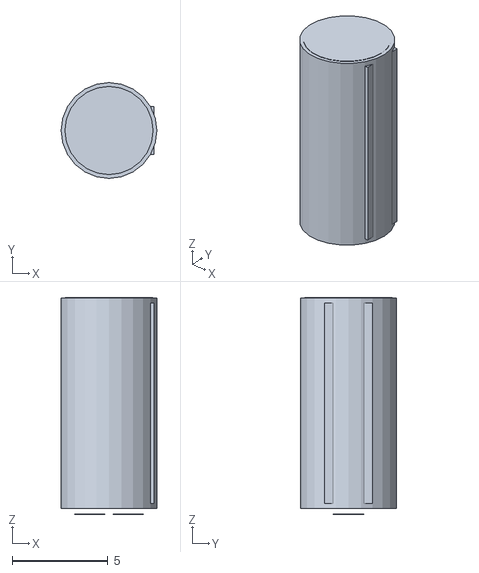
[picture p82: CAD file, 2026-09-26]
out/parts3d/CP-Radial-D5-H11.stl
5.00 x 5.00 x 11.3
