TakaI2/Drone_simulate/out/parts3d/Tact-3x4-SMD.stl

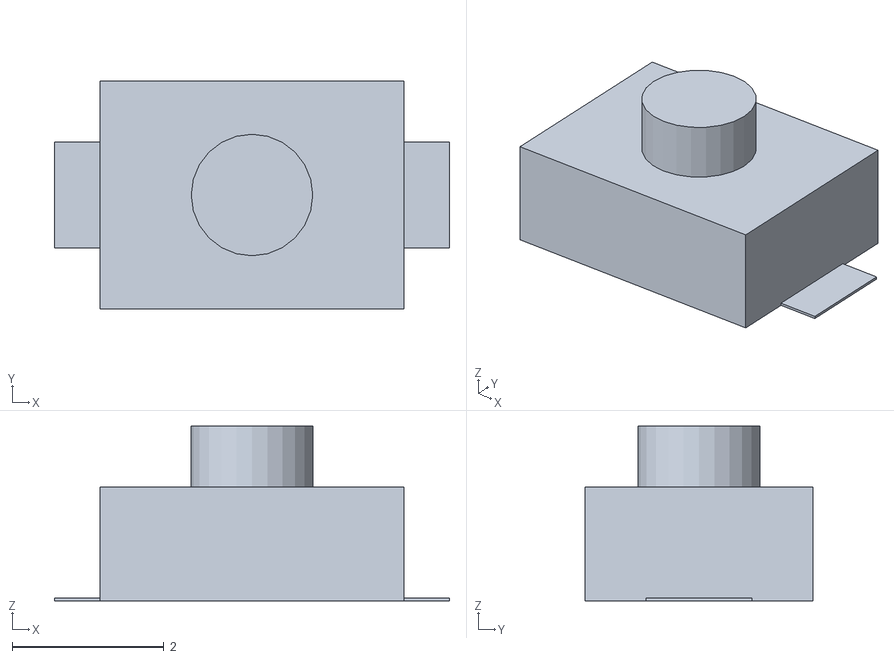
[picture p83: CAD file, 2026-09-26]
out/parts3d/Tact-3x4-SMD.stl
5.20 x 3.00 x 2.30
