TakaI2/Drone_simulate/(list of files, cad)

Other CAD files:
out/parts3d/MountHole-M2.stl
out/parts3d/MountHole-M3.stl
