TakaI2/Drone_simulate/out/variantC/fc.kicad_pcb

## KiCad design out/variantC/fc.kicad_pcb (2026-09-27)

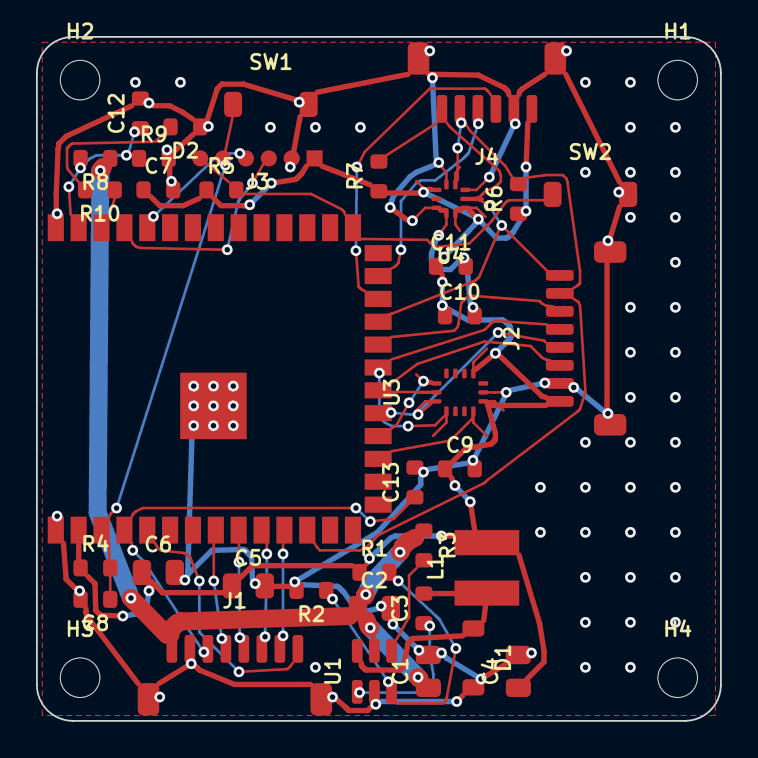
[picture p97: board fc.kicad_pcb from above]

Board: 2 copper layers, 38.0 x 38.0 mm, 40 parts (0 on the bottom side), 30 nets.

Parts:
C1, C2, C4, C5, C6: 10 µF; C0805
C3, C7, C9, C10, C11, C12, C13: 100 nF; C0603
C8: 1 µF; C0603
D1: B5819W; SOD-123
D2: APT1608EC; LED0603
H1, H2, H3, H4: —; MountHole-M2
J1, J2: SM08B-SRSS-TB(LF)(SN); JST-SH-8-SMD
J3: —; TestPad-1x6-1.27
J4: SM06B-SRSS-TB(LF)(SN); JST-SH-6-SMD
L1: 10 µH; L-Power-4x4
R1, R3, R8: 100kΩ; R0603
R2: 33kΩ; R0603
R4, R5, R9: 10kΩ; R0603
R6, R7: 4.7kΩ; R0603
R10: 1kΩ; R0603
SW1, SW2: TS-1187A-B-A-B; Tact-3x4-SMD
U1: MP2359DJ-LF-Z; SOT-23-6
U2: ESP32-S3-WROOM-1-N8; ESP32-S3-WROOM-1
U3: ICM-42688-P; LGA-14-2.5x3
U4: BMP390; LGA-10-2x2

Connections:
3V3: C4.1, C5.1, C6.1, C7.1, C9.1, C10.1, C11.1, J2.1, J3.1, J4.1, L1.2, R1.1, R4.1, R5.1, R6.1, R7.1, U2.2, U3.5, U3.8, U4.1, U4.6, U4.10
BOOT: J3.6, R5.2, SW2.1, U2.27
BST: C3.1, U1.1
BUCK_EN: R3.2, U1.4
EN: C8.1, J3.5, R4.2, SW1.1, U2.3
ESC_CURR: C13.1, J1.3, U2.4
ESC_M1: J1.4, U2.8
ESC_M2: J1.5, U2.9
ESC_M3: J1.6, U2.10
ESC_M4: J1.7, U2.11
ESC_TLM: J1.8, U2.5
FB: R1.2, R2.1, U1.3
FLOW_CS: J2.6, U2.22
GND: C1.2, C2.2, C4.2, C5.2, C6.2, C7.2, C8.2, C9.2, C10.2, C11.2, C12.2, C13.2, D1.2, D2.1, J1.2, J1.MP1, J1.MP2, J2.2, J2.MP1, J2.MP2, J3.2, J4.2, J4.MP1, J4.MP2, R2.2, R9.2, SW1.2, SW2.2, U1.2, U2.1, U2.40, U2.41, U3.6, U4.3, U4.5, U4.8, U4.9
GNSS_RX: J4.4, U2.25
GNSS_TX: J4.3, U2.24
I2C_SCL: J2.8, J4.6, R7.2, U2.23, U4.2
I2C_SDA: J2.7, J4.5, R6.2, U2.12, U4.4
IMU_CS: U2.18, U3.12
IMU_INT: U2.17, U3.4
LED: R10.1, U2.38
LED_A: D2.2, R10.2
RXD0: J3.4, U2.36
SPI_MISO: J2.5, U2.21, U3.1
SPI_MOSI: J2.4, U2.19, U3.14
SPI_SCK: J2.3, U2.20, U3.13
SW: C3.2, D1.1, L1.1, U1.6
TXD0: J3.3, U2.37
VBAT: C1.1, C2.1, J1.1, R3.1, R8.1, U1.5
VBAT_SENSE: C12.1, R8.2, R9.1, U2.39
