TakaI2/Drone_simulate/out/variantB/main.kicad_pcb

## KiCad design out/variantB/main.kicad_pcb (2026-09-27)

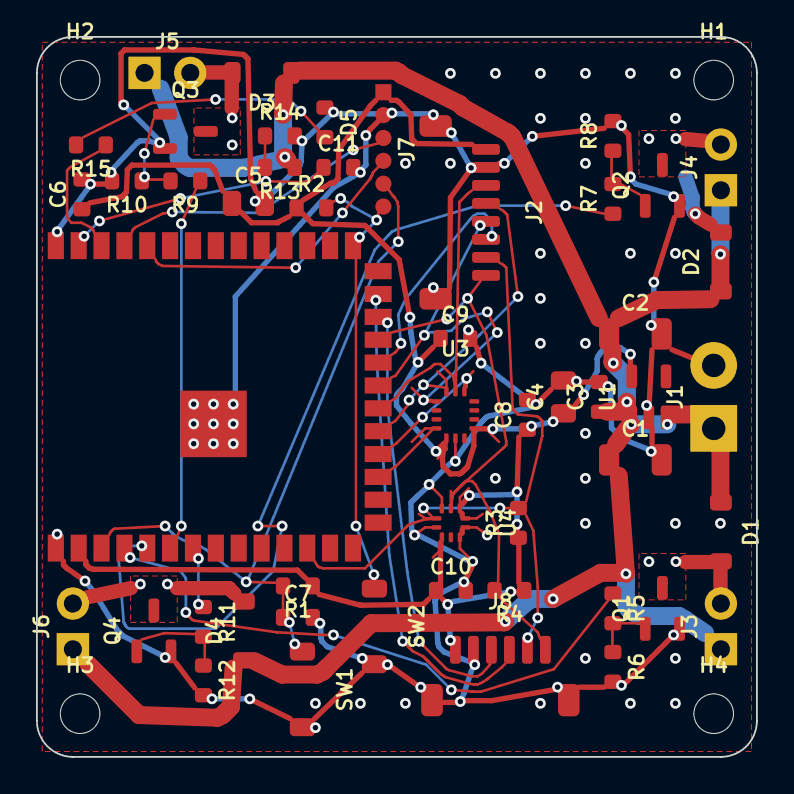
[picture p98: board main.kicad_pcb from above]

Board: 2 copper layers, 40.0 x 40.0 mm, 53 parts (0 on the bottom side), 32 nets.

Parts:
C1, C2: 47 µF; C1206
C3, C7: 1 µF; C0603
C4, C5: 10 µF; C0805
C6, C8, C9, C10, C11: 100 nF; C0603
D1, D2, D3, D4: B5819W; SOD-123
D5: APT1608EC; LED0603
H1, H2, H3, H4: —; MountHole-M2
J1: —; BatteryPad-2
J2: SM08B-SRSS-TB(LF)(SN); JST-SH-8-SMD
J3, J4, J5, J6: —; MotorPad-2
J7: —; TestPad-1x6-1.27
J8: SM06B-SRSS-TB(LF)(SN); JST-SH-6-SMD
Q1, Q2, Q3, Q4: AO3400A; SOT-23
R1, R2, R6, R8, R10, R12: 10kΩ; R0603
R3, R4: 4.7kΩ; R0603
R5, R7, R9, R11: 47Ω; R0603
R13, R14: 100kΩ; R0603
R15: 1kΩ; R0603
SW1, SW2: TS-1187A-B-A-B; Tact-3x4-SMD
U1: XC6220B331MR-G; SOT-23-5
U2: ESP32-S3-WROOM-1-N8; ESP32-S3-WROOM-1
U3: ICM-42688-P; LGA-14-2.5x3
U4: BMP390; LGA-10-2x2

Connections:
3V3: C4.1, C5.1, C6.1, C8.1, C9.1, C10.1, J2.1, J7.1, J8.1, R1.1, R2.1, R3.1, R4.1, U1.5, U2.2, U3.5, U3.8, U4.1, U4.6, U4.10
BOOT: J7.6, R2.2, SW2.1, U2.27
EN: C7.1, J7.5, R1.2, SW1.1, U2.3
FLOW_CS: J2.6, U2.22
GATE1: Q1.1, R5.2, R6.1
GATE2: Q2.1, R7.2, R8.1
GATE3: Q3.1, R9.2, R10.1
GATE4: Q4.1, R11.2, R12.1
GND: C1.2, C2.2, C3.2, C4.2, C5.2, C6.2, C7.2, C8.2, C9.2, C10.2, C11.2, D5.1, J1.2, J2.2, J2.MP1, J2.MP2, J7.2, J8.2, J8.MP1, J8.MP2, Q1.2, Q2.2, Q3.2, Q4.2, R6.2, R8.2, R10.2, R12.2, R14.2, SW1.2, SW2.2, U1.2, U2.1, U2.40, U2.41, U3.6, U4.3, U4.5, U4.8, U4.9
GNSS_RX: J8.4, U2.25
GNSS_TX: J8.3, U2.24
I2C_SCL: J2.8, J8.6, R4.2, U2.23, U4.2
I2C_SDA: J2.7, J8.5, R3.2, U2.12, U4.4
IMU_CS: U2.18, U3.12
IMU_INT: U2.17, U3.4
LED: R15.1, U2.38
LED_A: D5.2, R15.2
MOT1-: D1.2, J3.2, Q1.3
MOT2-: D2.2, J4.2, Q2.3
MOT3-: D3.2, J5.2, Q3.3
MOT4-: D4.2, J6.2, Q4.3
PWM1: R5.1, U2.4
PWM2: R7.1, U2.5
PWM3: R9.1, U2.6
PWM4: R11.1, U2.7
RXD0: J7.4, U2.36
SPI_MISO: J2.5, U2.21, U3.1
SPI_MOSI: J2.4, U2.19, U3.14
SPI_SCK: J2.3, U2.20, U3.13
TXD0: J7.3, U2.37
VBAT: C1.1, C2.1, C3.1, D1.1, D2.1, D3.1, D4.1, J1.1, J3.1, J4.1, J5.1, J6.1, R13.1, U1.1, U1.3
VBAT_SENSE: C11.1, R13.2, R14.1, U2.39
