TakaI2/Drone_simulate/out/variantB/flow.kicad_pcb

## KiCad design out/variantB/flow.kicad_pcb (2026-09-27)

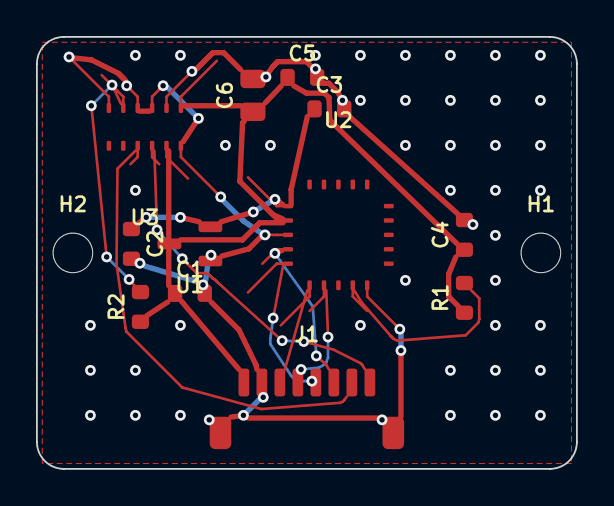
[picture p99: board flow.kicad_pcb from above]

Board: 2 copper layers, 30.0 x 24.0 mm, 14 parts (0 on the bottom side), 11 nets.

Parts:
C1, C2: 1 µF; C0603
C3, C4, C5: 100 nF; C0603
C6: 10 µF; C0805
H1, H2: —; MountHole-M2
J1: SM08B-SRSS-TB(LF)(SN); JST-SH-8-SMD
R1, R2: 10kΩ; R0603
U1: XC6206P182MR-G; SOT-23
U2: PMW3901MB-TXQT; PMW3901MB
U3: VL53L1CXV0FY/1; VL53L1X-LGA12

Connections:
1V8: C2.1, C3.1, U1.2, U2.1
3V3: C1.1, C4.1, C5.1, C6.1, J1.1, R1.1, R2.1, U1.3, U2.2, U3.1, U3.11
FLOW_CS: J1.6, U2.4
FLOW_NRST: R1.2, U2.9
GND: C1.2, C2.2, C3.2, C4.2, C5.2, C6.2, J1.2, J1.MP1, J1.MP2, U1.1, U2.3, U2.10, U3.2, U3.3, U3.4, U3.6, U3.12
I2C_SCL: J1.8, U3.10
I2C_SDA: J1.7, U3.9
SPI_MISO: J1.5, U2.5
SPI_MOSI: J1.4, U2.7
SPI_SCK: J1.3, U2.6
TOF_XSHUT: R2.2, U3.5
