TakaI2/Drone_simulate/(commit log)

2026-09-25 Stage 1: flight simulator, controller, planner, UI and report
    - 6DOF RK4 dynamics with electrical motor model, LiPo sag, ground effect, drag, gusts
    - Sensor noise + Mahony/3-state KF estimator
    - PX4-style cascaded control with generic N-rotor allocation and desaturation
    - Voxel A* planner with shortcutting and carrot follower
    - Three.js UI (course/environment editing, manual flight), HTML report with screenshots
    - Spec docs in .tmp (requirements review, design, test design, tasks)
2026-09-25 Stage 2: propulsion sizing, parts catalog, circuit generation, electrical checks
    - Motor/battery coupled sizing with catalog search (generic parts first) and mass convergence loop
    - Class A flight-controller circuit generator (ESP32-S3, ICM-42688-P, BMP390, AO3400A drivers)
    - 22 electrical design checks (MOSFET thermal, LDO, flyback, divider, I2C, IPC-2221 widths)
    - Net-label schematic SVG, KiCad netlist, BOM CSV with alternatives and vendor search links
    - Electrical UI tab and stage 2 HTML report
    [bom.csv]
2026-09-26 Stage 3: parts 3D library, breadboard layout, PCB auto place/route, Gerber output
    - Parametric package library (47 packages) as single source for footprints and 3D; STL archive
    - Constructive placement with anchors (module antenna overhang, motor pads on arm rays)
    - Fine-pitch fan-out (centre-first), module/sensor keep-outs
    - 2-layer grid A* router with EDT clearance, neck-down, rip-up & reroute, GND strategies
    - Ground pour with stitching vias, island removal and plane repair; thermal copper/vias
    - Exact-geometry DRC; Gerber RS-274X X2, Excellon, CPL, JLC BOM, KiCad board export
    - Independent Gerber validation/rendering with tracespace; breadboard layout with checks
    - PCB UI tab and stage 3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
    [Axial-R-10.16.stl, BatteryPad-2.stl, C-Disc-D5.stl, C0402.stl, C0603.stl, C0805.stl, C1206.stl, C1210.stl]
2026-09-26 Stages 4-5: airframe design, integration, sim-to-real study, overall report
    - Parametric printable frame via manifold-3d (watertight STL), mesh mass properties
    - Battery position solved for CG = thrust centre; strap slots placed accordingly
    - Prop clearance, arm stress, AUW checks; assembled 3D vehicle (frame+PCB+parts+motors+props+battery)
    - Derive simulation parameters from stage 2-4 design; re-run stage-1 goals
    - Plant/controller model split for sensitivity (CT, CP, tau, mass, inertia, CG, motor, battery)
    - Assembly tab: completed vehicle flies in the simulator; overall index report
    - Tests for sizing, electrical, DRC/router/Gerber, packages, mass props, integration (25 total)
    - Fix QFN-3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
    [QFN-32-5x5.stl, TO-92.stl, frame.stl]
2026-09-27 Variant B: designed flow/ToF sensor sub-board, GNSS port, outdoor GNSS flight
    - Sensor sub-board (PMW3901 + VL53L1X + 1.8 V LDO) auto placed/routed (30x24 mm), Gerber/KiCad/3D
    - Main board option with JST-SH 6 GNSS+compass port (UART1 IO47/IO48, shared I2C)
    - Frame B: longer nose, sub-board holes, cable slot; assembly shows sub-board component-side down
    - GNSS Gauss-Markov position/baro error model, outdoor environment and scenarios (GB-5a/b)
    - Estimator fix: tilt was unobservable (accel compensation cancelled itself); aided-INS tilt
    correction from the position filter's accel-bias estimate; variant A re-verified (all pass)
    - Placement options for small boards (largest-first, anchors, fan-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
    [flow.kicad_pcb, frame.stl, main.kicad_pcb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]
2026-09-27 Variant C: outdoor vehicle (brushless 2S, ESC harness, buck FC, GNSS, RTH)
    - Outdoor propulsion candidates/rules/mass model, frame-mass calibration loop
    - Circuit options: step-down supply (MP2359) and 4-in-1 ESC harness; ESC electrical checks
    - 38x38 FC board auto place/route, frame generator: bolt-on motor pads, ESC stack, GNSS on nose
    - Return-to-home failsafe, outdoor gains and scenarios, thrust-margin and wind-limit comparison
    - Report variantC.html, UI variant C; variants A/B unchanged
    [JST-SH-6-SMD.stl, PMW3901MB.stl, VL53L1X-LGA12.stl, bom.csv, fc.kicad_pcb, frame.stl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]
2026-09-28 City simulation (Yokohama Minatomirai), estimator fix, user manual
    - PLATEAU (range reads from the city ZIP) + OSM buildings as prism obstacles, ENU conversion
    - Prism collision/voxelization, obstacle grid index, course planner overrides
    - Sky-view map and urban GNSS degradation, power-law wind profile
    - City scenarios GY-1..GY-6, legal notes, reports/city.html, UI tab 6
    - Estimator: learn gyro bias from the aided-INS tilt error (fixes tilt drift after long flights); A/B/C re-verified
    - docs/manual.md with screenshots (npm run manual)
2026-09-28 UI: follow cameras (orbit/chase/top) and replay of recorded flights; manual updated
2026-09-28 Budget: reference price table (web-checked / estimated) and cost of variants A/B/C
    - src/budget: price records with source, date and range; JLCPCB order model; budget calculator
    - reports/budget.html, out/budget (json/csv); manual section and report navigation
    [budget.csv]
2026-10-01 Videos: frame-by-frame capture of follow-camera flights and orbiting boards/vehicles
    - Capture hooks for viewport/sim (capture mode), scripts/videos.ts (ffmpeg VP8)
    - docs/video: indoor, outdoor, city chase flights; A/B/C airframes and boards orbit
    - Manual section 5 (videos)
2026-10-17 Prepare for Netlify: site build with data/reports/docs, manual HTML, notice page, MIT license
    - vite.config: copy out/, reports/, docs/ into dist and render docs/manual.md to HTML
    - notice.html (disclaimer, data attribution), header links (manual, reports, notice)
    - LICENSE (MIT), THIRD_PARTY_NOTICES.md (PLATEAU, OSM ODbL, libraries), README, netlify.toml
2026-10-17 Fix lint: escape the CSV BOM in the budget script
2026-10-17 Fix lint: escape the CSV BOM in the budget script (source)
